NicolasJao/CAPSTONE-4TR1-Sushi-Assembly-Line/README.md

# CAPSTONE-4TR1-Sushi-Assembly-Line
My work for the PROCTECH 4TR1 course (McMaster BTech Automation). This is my CAPSTONE project with my group members. We are making an automated assembly line that makes sushi.
