NicolasJao/CAPSTONE-4TR1-Sushi-Assembly-Line/Project Documentation/Reports/Semester 1/Project Proposal Presentation.pdf

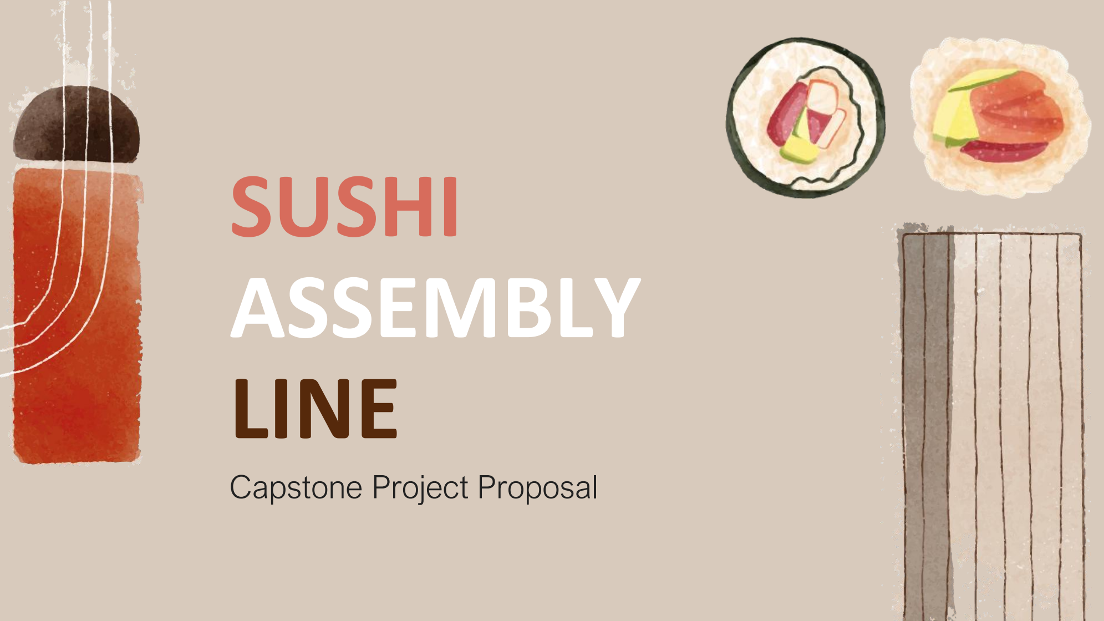
[picture p1: page 1]

# SUSHI ASSEMBLY LINE

# Capstone Project Proposal

# MEET THE TEAM

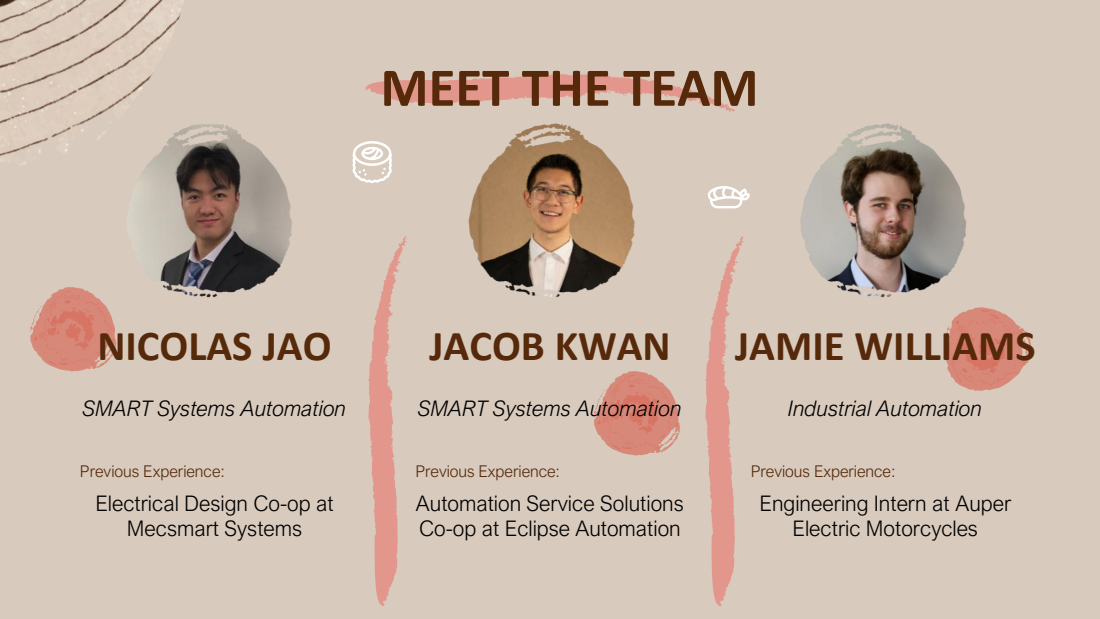
[picture p2: page 2]
NICOLAS JAO; JACOB KWAN; JAMIE WILLIAMS; SMART Systems Automation; Industrial Automation

Previous Experience:
Electrical Design Co-op at
Mecsmart Systems

Automation Service Solutions
Co-op at Eclipse Automation

Engineering Intern at Auper
Electric Motorcycles

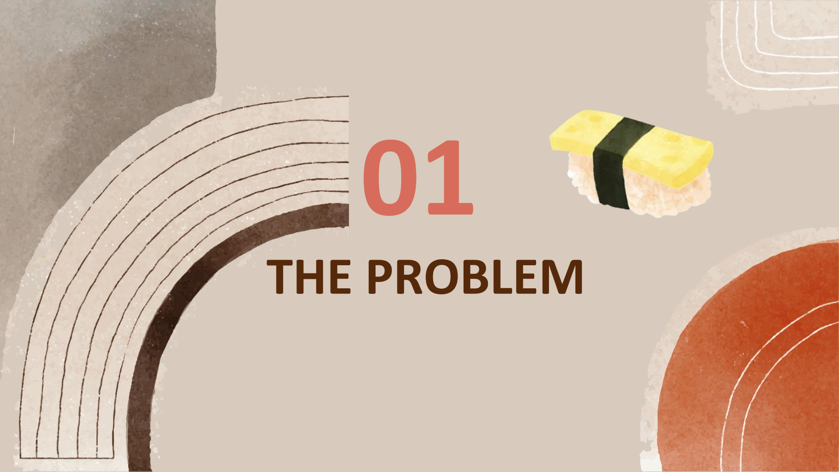
[picture p3: page 3]

# THE PROBLEM

01

# THE PROBLEM

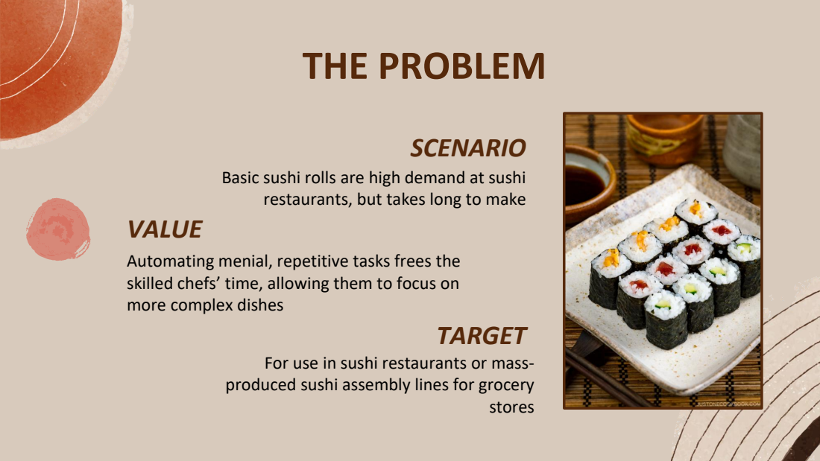
[picture p4: page 4]
SCENARIO; VALUE; TARGET; stores

Basic sushi rolls are high demand at sushi
restaurants, but takes long to make

Automating menial, repetitive tasks frees the
skilled chefs’ time, allowing them to focus on
more complex dishes

For use in sushi restaurants or mass-
produced sushi assembly lines for grocery

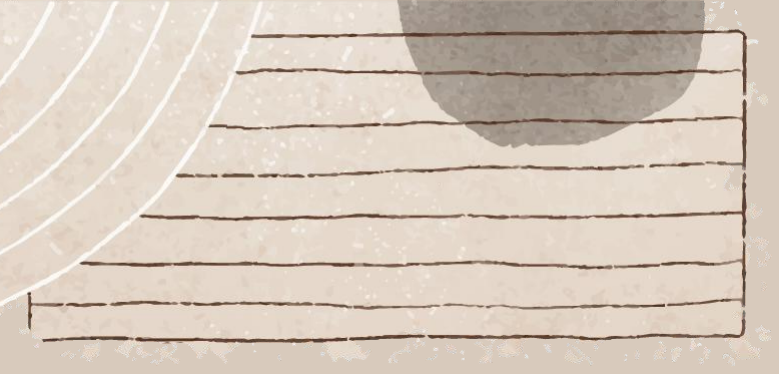
[picture p5: figure]

02

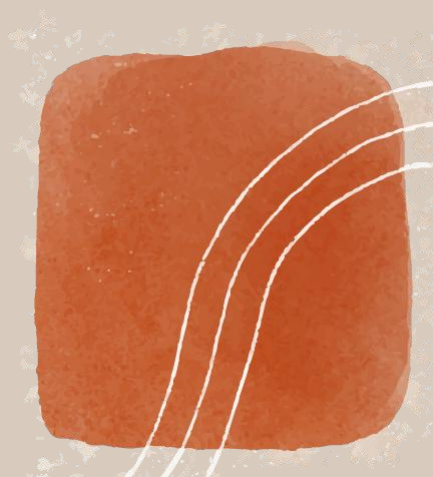
[picture p6: figure]

# THE MISSION

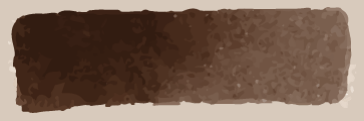
[picture p7: figure]
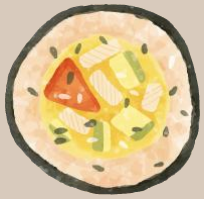
[picture p8: figure]

# THE MISSION

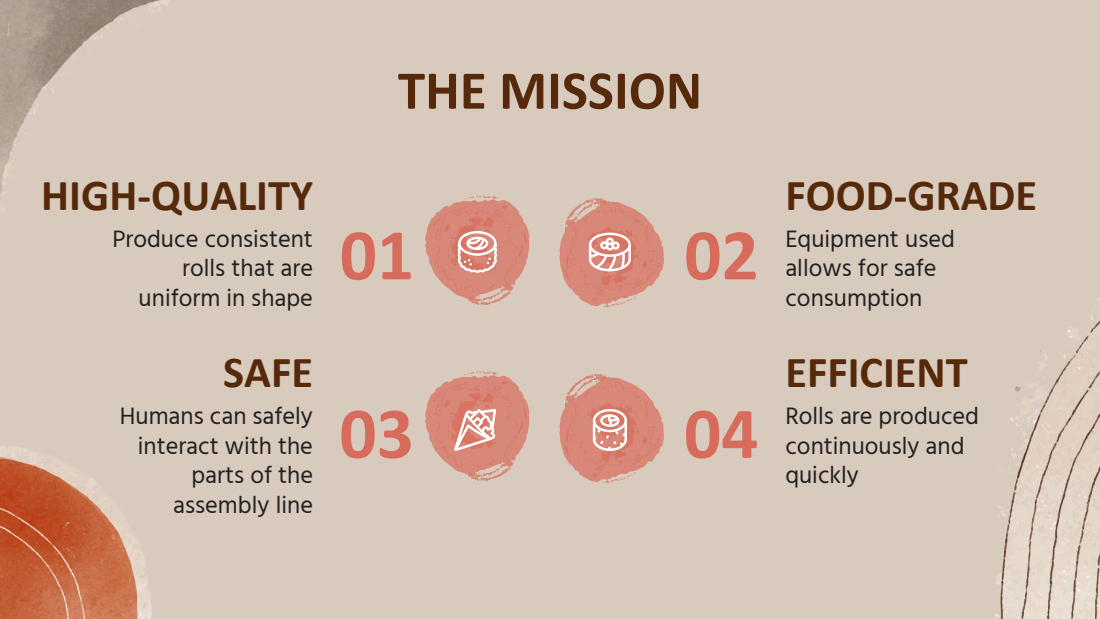
[picture p9: page 6]

HIGH-QUALITY
Produce consistent
rolls that are
uniform in shape
SAFE
Humans can safely

FOOD-GRADE
Equipment used
allows for safe
consumption
EFFICIENT
Rolls are produced
continuously and
quickly

interact with the
parts of the
assembly line

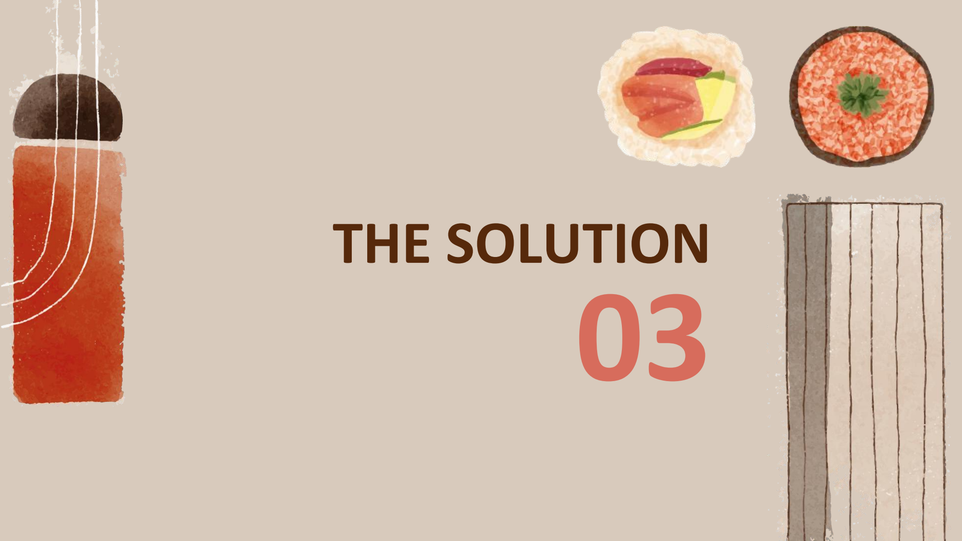
[picture p10: page 7]

# THE SOLUTION

03

## 01 Assembling the rice and nori

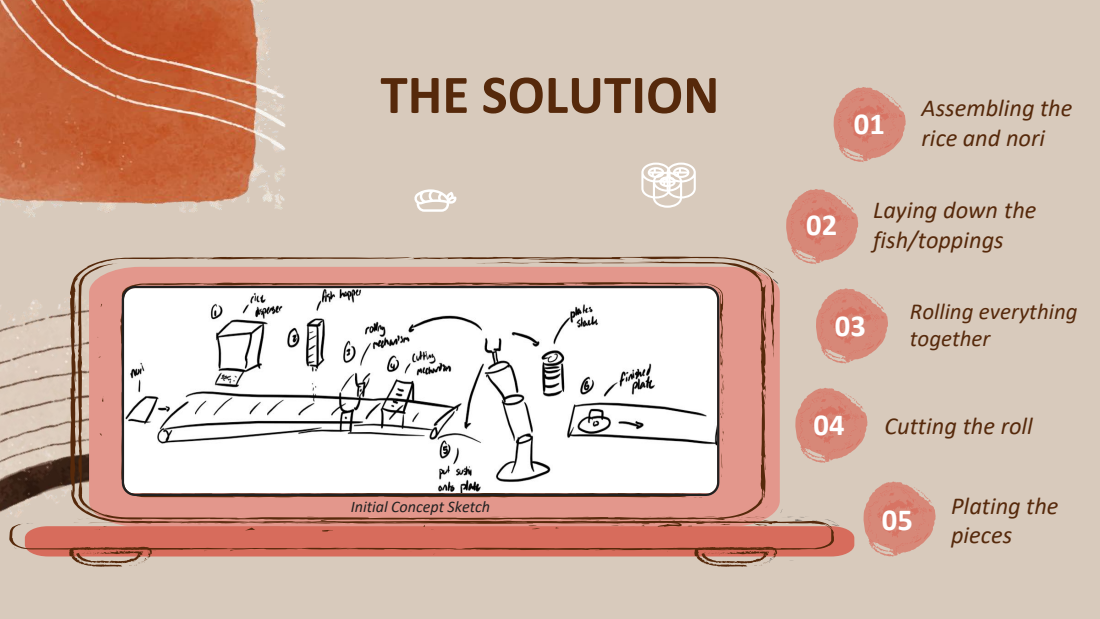
[picture p11: page 8]
03 Rolling everything together; 05 Plating the pieces; THE SOLUTION

02 Laying down the
fish/toppings

04 Cutting the roll

Initial Concept Sketch

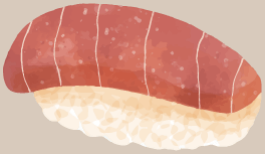
[picture p12: figure]

04

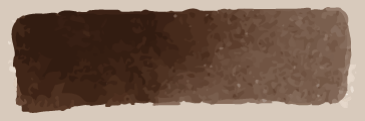
[picture p13: figure]
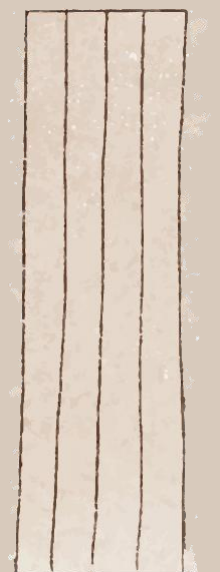
[picture p14: figure]

# THE TIMELINE

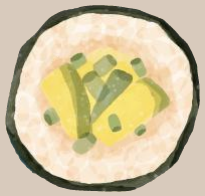
[picture p15: figure]
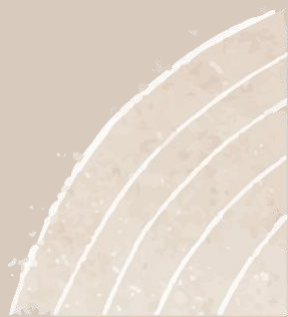
[picture p16: figure]

T
H

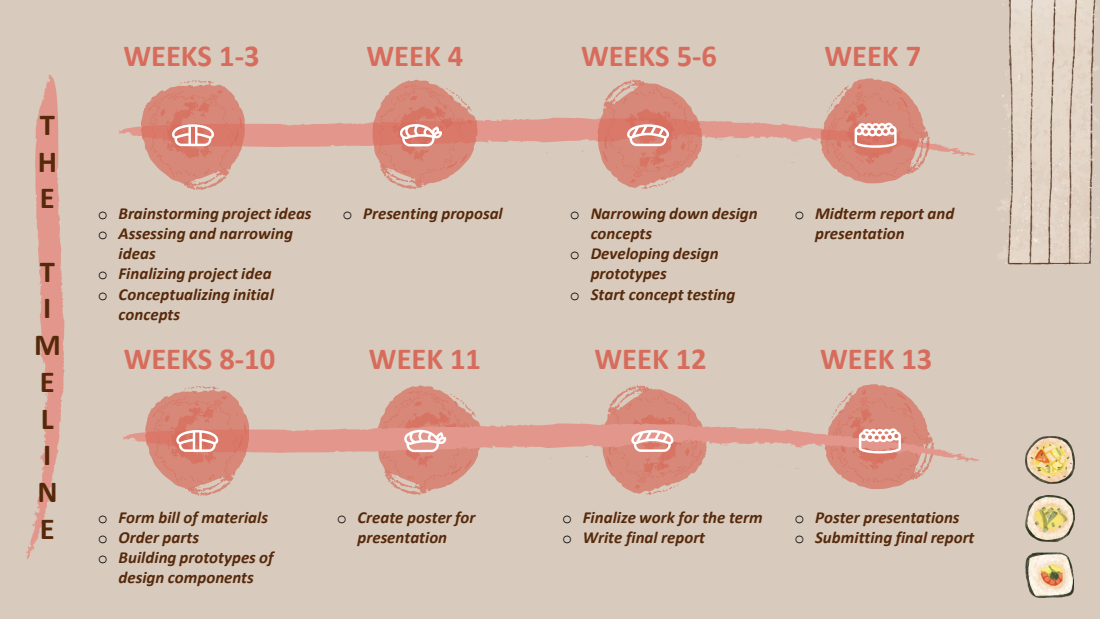
[picture p17: page 10]
• Brainstorming project ideas • Assessing and narrowing ideas; WEEKS 1-3; WEEK 4; WEEKS 5-6; WEEK 7; • Presenting proposal; o Narrowing down design; WEEKS 8-10; WEEK 11; WEEK 12; WEEK 13

• Midterm report and
presentation

concepts
• Developing design
prototypes
• Start concept testing

• Finalizing project idea
• Conceptualizing initial

• Form bill of materials
• Order parts
• Building prototypes of
design components

• Create poster for

• Finalize work for the term
• Write final report

• Poster presentations
• Submitting final report

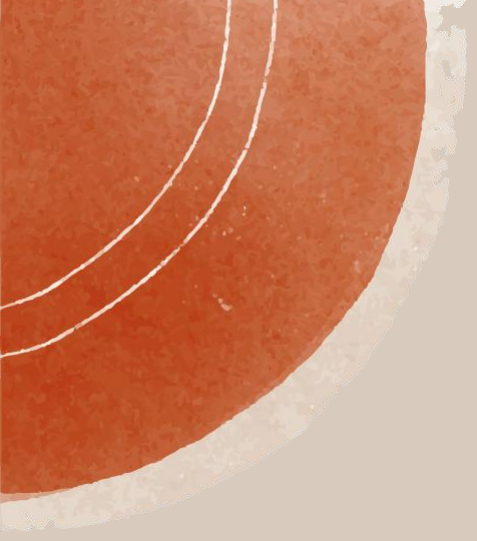
[picture p18: figure]
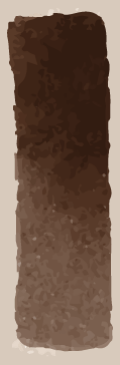
[picture p19: figure]

# THANK YOU

# QUESTIONS?

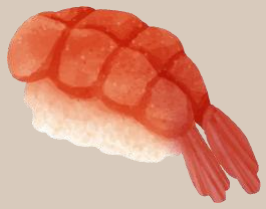
[picture p20: figure]
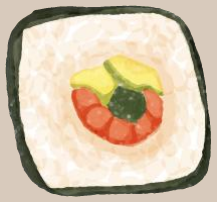
[picture p21: figure]
