NicolasJao/CAPSTONE-4TR1-Sushi-Assembly-Line/Project Documentation/Reports/Semester 2/Sushi Assembly Line Midterm Presentation 2.pdf

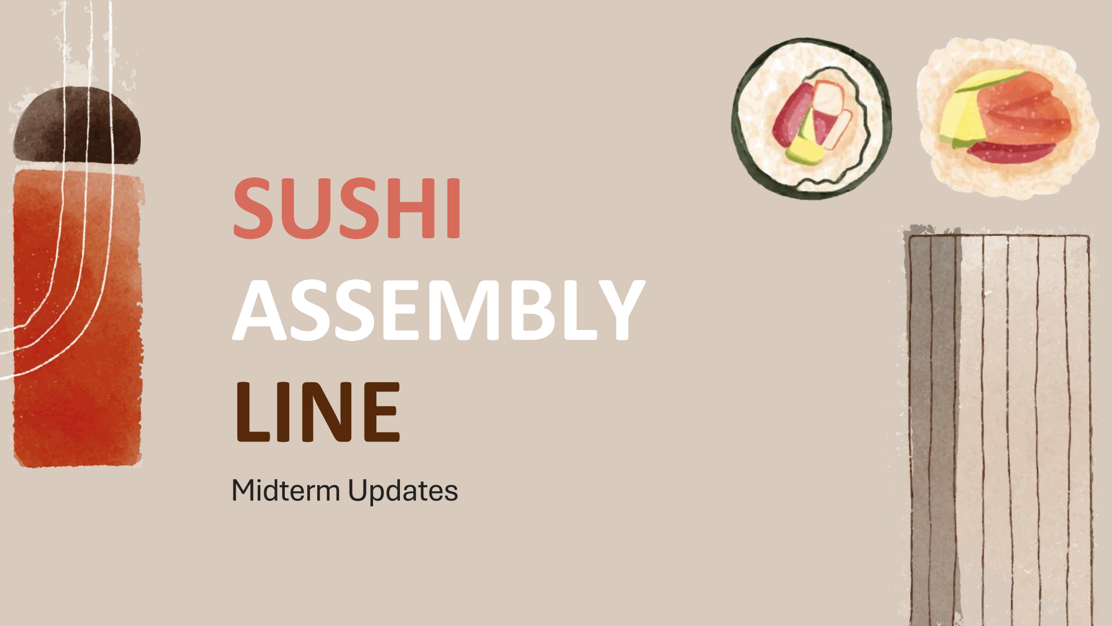
[picture p41: page 1]

# SUSHI ASSEMBLY LINE

## Midterm Updates

# MEET THE TEAM

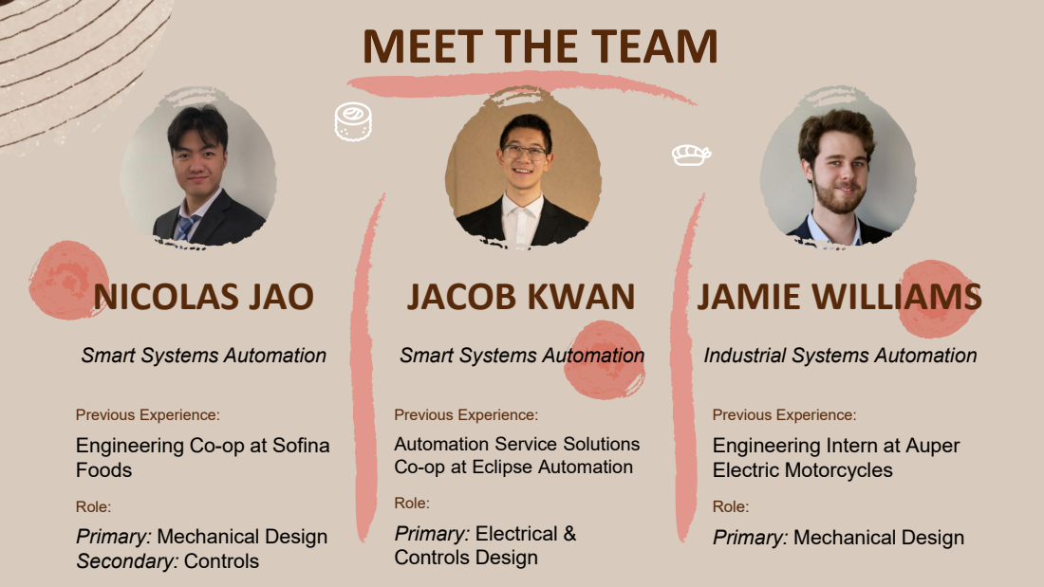
[picture p42: page 2]
NICOLAS JAO; JACOB KWAN; JAMIE WILLIAMS; Smart Systems Automation; Industrial Systems Automation; Role: Primary: Electrical & Controls Design

Previous Experience:
Engineering Co-op at Sofina
Foods

Automation Service Solutions
Co-op at Eclipse Automation

Engineering Intern at Auper
Electric Motorcycles

Role:
Primary: Mechanical Design
Secondary: Controls

01

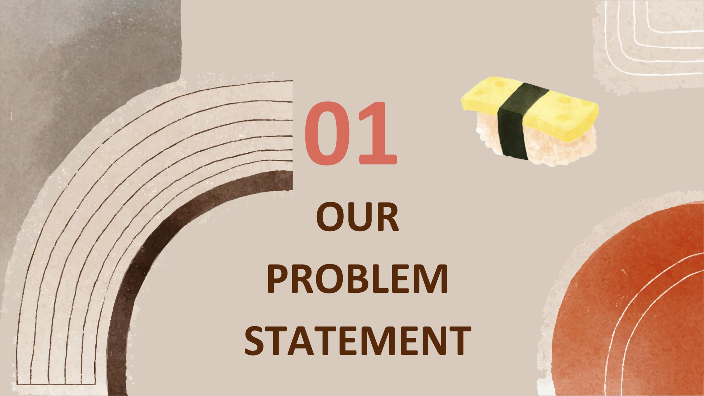
[picture p43: page 3]

# OUR PROBLEM STATEMENT

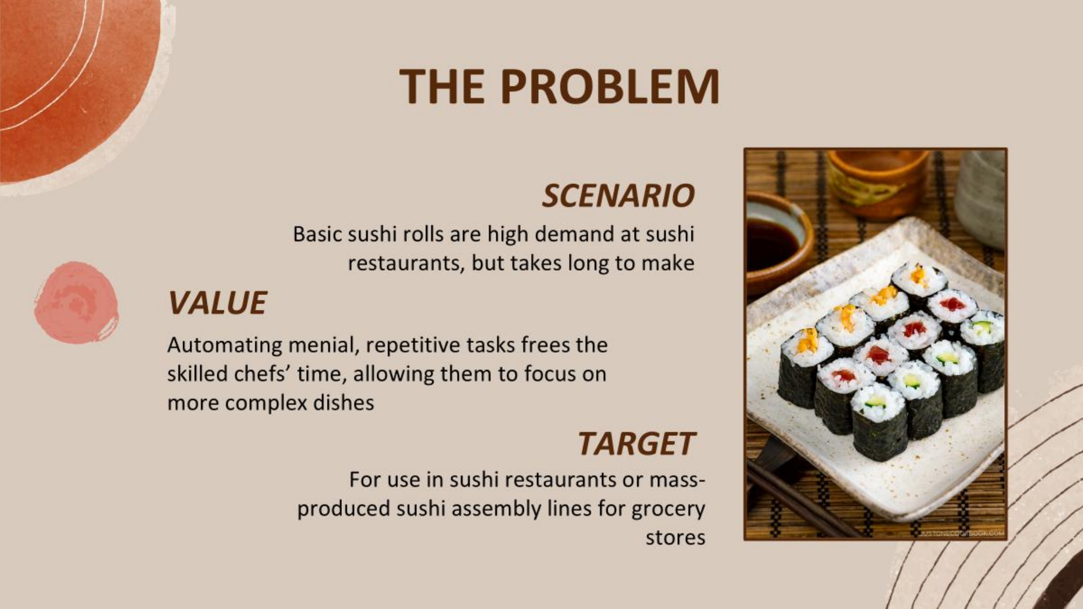
[picture p44: page 4]

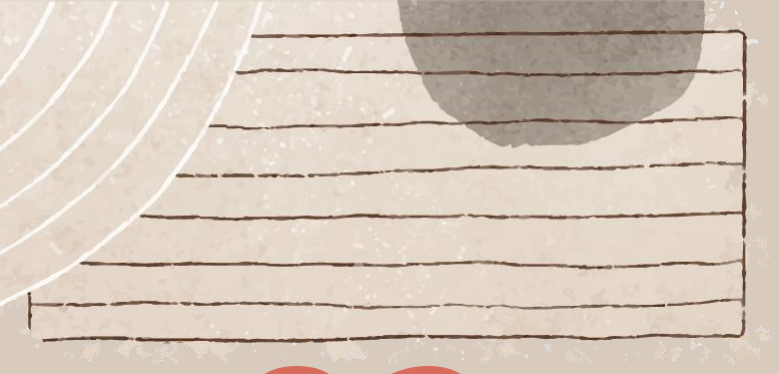
[picture p45: figure]

02


# OUR OBJECTIVES AND DESIGNS


# OBJECTIVES

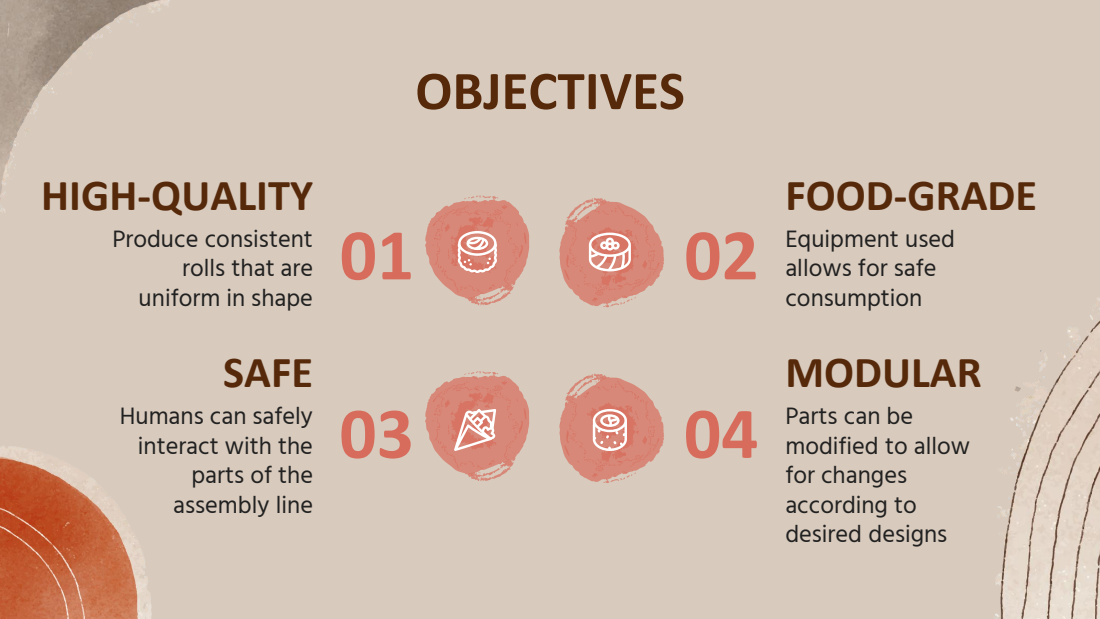
[picture p46: page 6]

HIGH-QUALITY
Produce consistent
rolls that are
uniform in shape
SAFE
Humans can safely

FOOD-GRADE
Equipment used
allows for safe
consumption
MODULAR
Parts can be
modified to allow
for changes
according to
desired designs

interact with the
parts of the
assembly line

# 5 STATIONS:

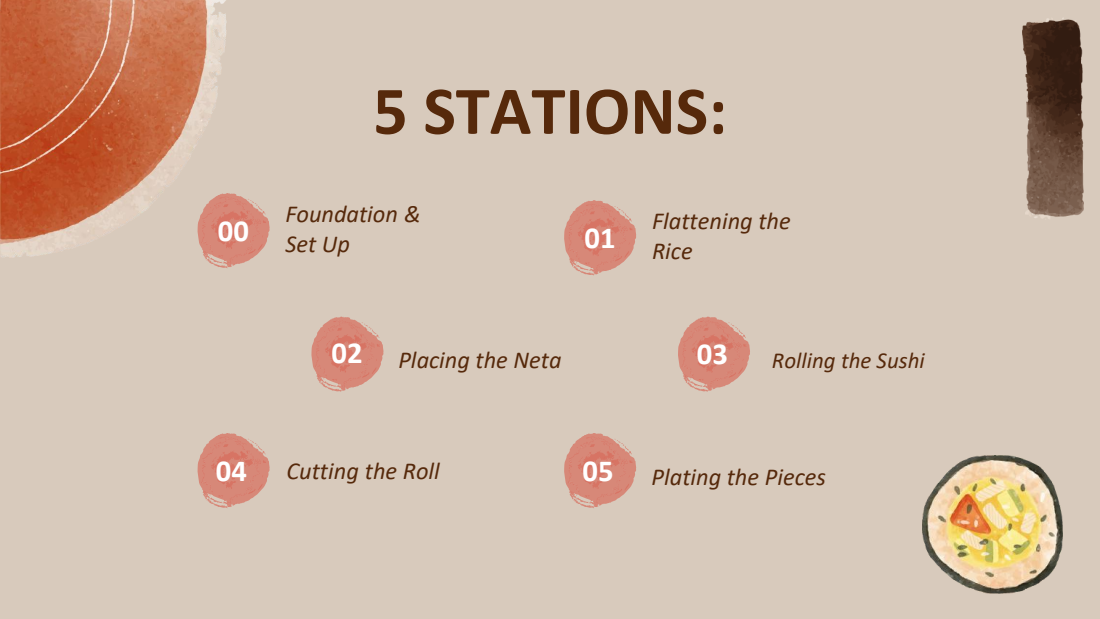
[picture p47: page 7]
00 Foundation & Set Up; Cutting the Roll; Plating the Pieces; 02 Placing the Neta; Rolling the Sushi; 01 Flattening the Rice

# 0. FOUNDATION & SET UP

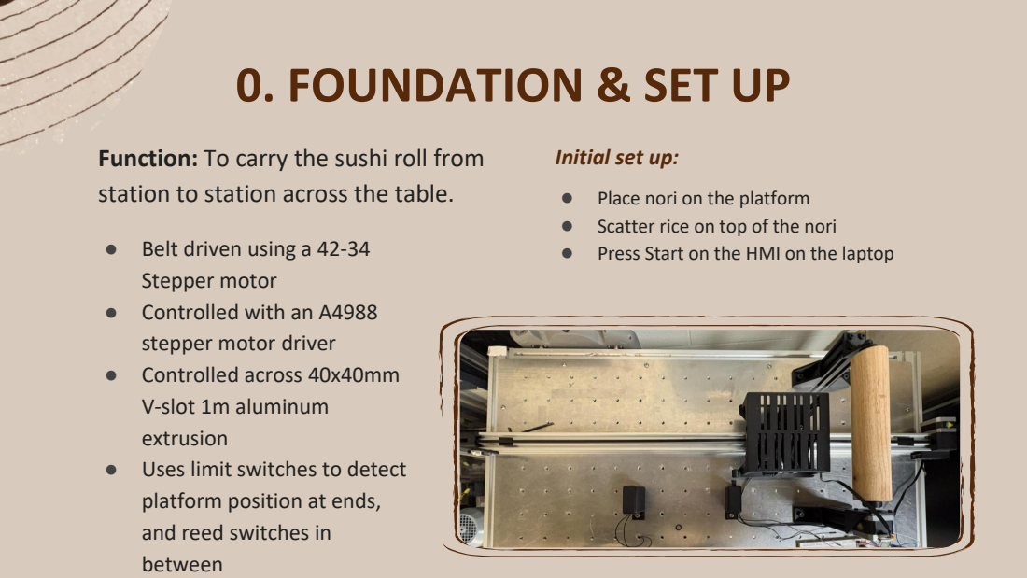
[picture p48: page 8]

Function: To carry the sushi roll from
station to station across the table.

Initial set up:

● Place nori on the platform
● Scatter rice on top of the nori
● Press Start on the HMI on the laptop

● Belt driven using a 42-34
Stepper motor
● Controlled with an A4988
stepper motor driver
● Controlled across 40x40mm
V-slot 1m aluminum
extrusion
● Uses limit switches to detect
platform position at ends,
and reed switches in
between

# 1. FLATTENING THE RICE

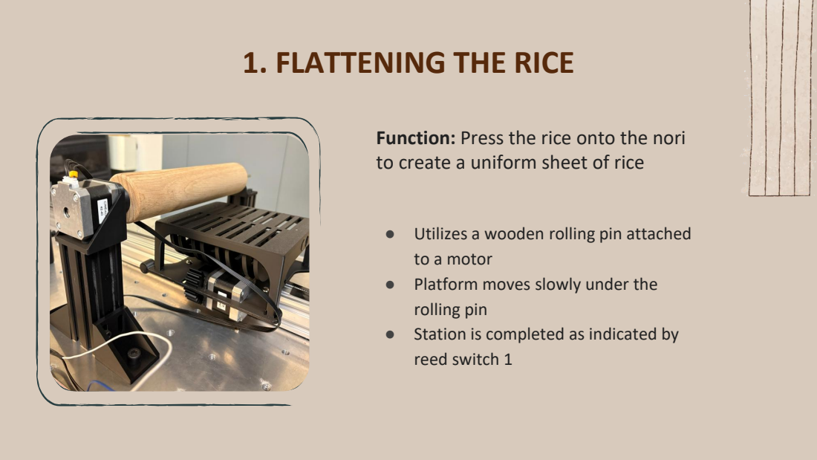
[picture p49: page 9]

Function: Press the rice onto the nori
to create a uniform sheet of rice

● Utilizes a wooden rolling pin attached
to a motor
● Platform moves slowly under the
rolling pin
● Station is completed as indicated by
reed switch 1

# 2. PLACING THE NETA (TOPPINGS)

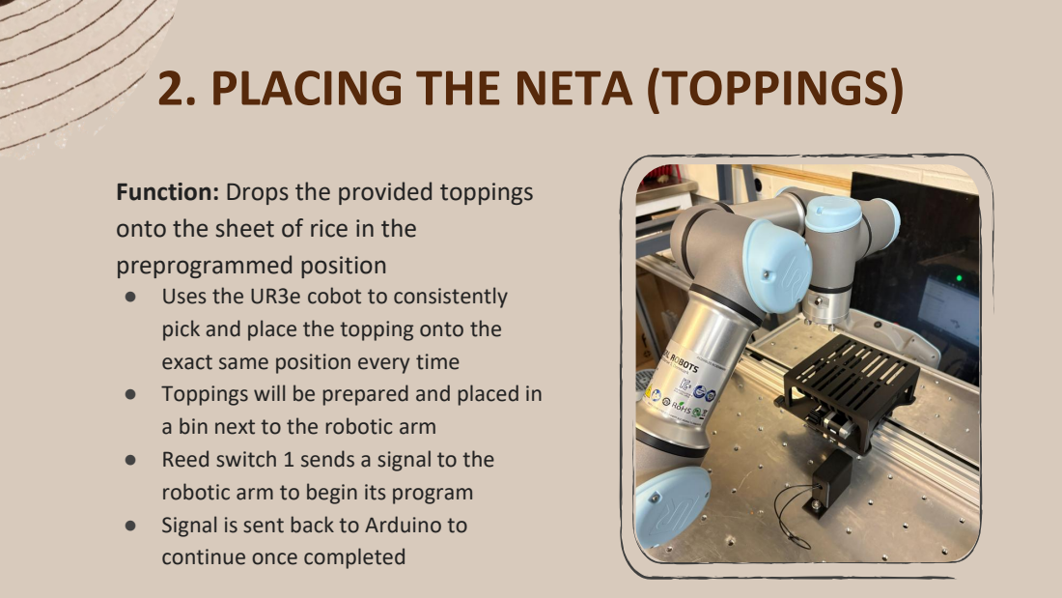
[picture p50: page 10]

Function: Drops the provided toppings
onto the sheet of rice in the
preprogrammed position
● Uses the UR3e cobot to consistently
pick and place the topping onto the
exact same position every time
● Toppings will be prepared and placed in
a bin next to the robotic arm
● Reed switch 1 sends a signal to the
robotic arm to begin its program
● Signal is sent back to Arduino to
continue once completed

# 3. ROLLING THE SUSHI

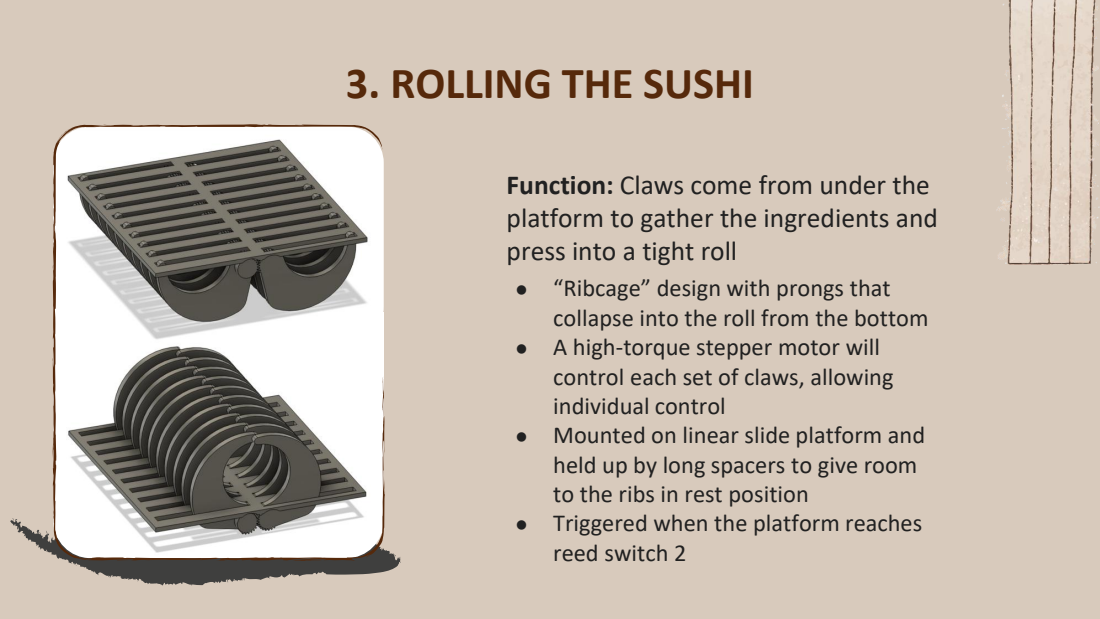
[picture p51: page 11]

Function: Claws come from under the
platform to gather the ingredients and
press into a tight roll
● “Ribcage” design with prongs that
collapse into the roll from the bottom
● A high-torque stepper motor will
control each set of claws, allowing
individual control
● Mounted on linear slide platform and
held up by long spacers to give room
to the ribs in rest position
● Triggered when the platform reaches
reed switch 2

# 4. CUTTING THE ROLL

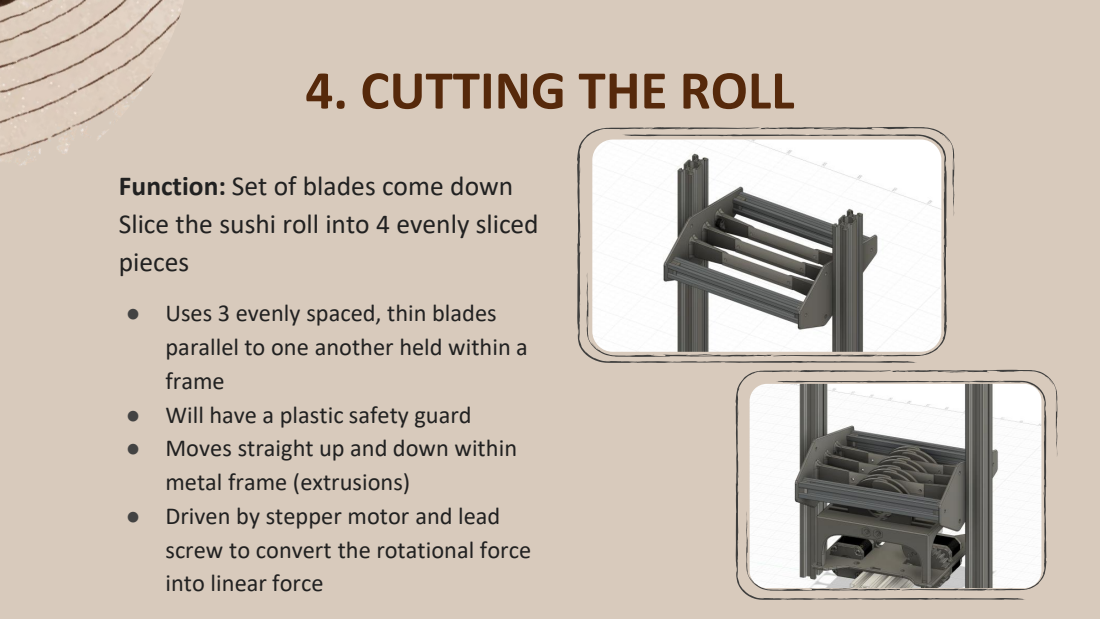
[picture p52: page 12]

Function: Set of blades come down
Slice the sushi roll into 4 evenly sliced
pieces

● Uses 3 evenly spaced, thin blades
parallel to one another held within a
frame
● Will have a plastic safety guard
● Moves straight up and down within
metal frame (extrusions)
● Driven by stepper motor and lead
screw to convert the rotational force
into linear force

# 5. PLATING THE ROLLS

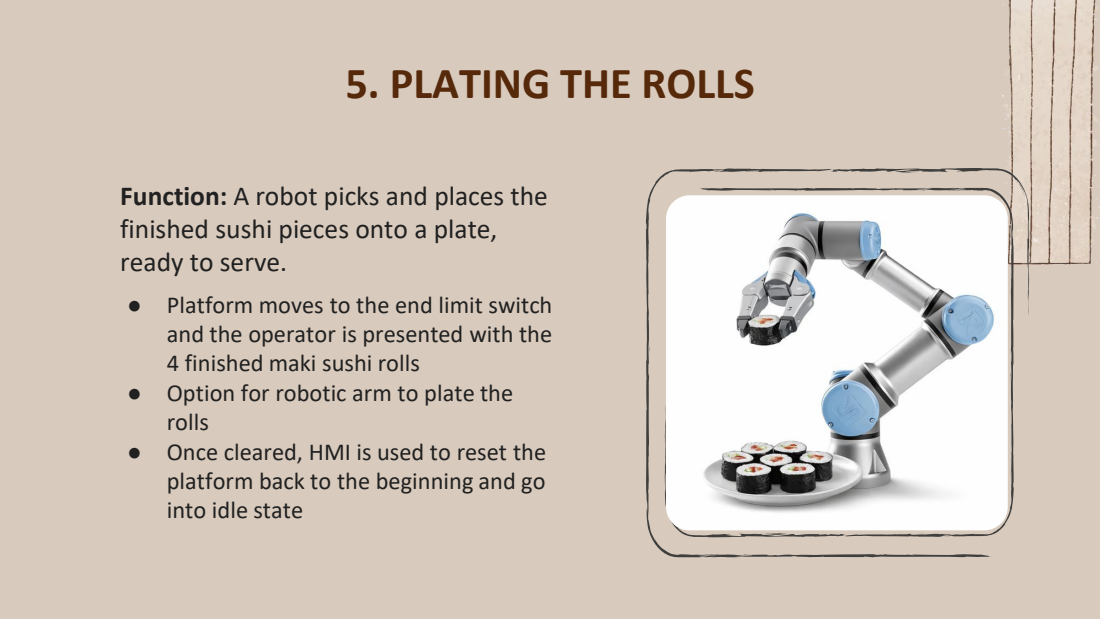
[picture p53: page 13]

Function: A robot picks and places the
finished sushi pieces onto a plate,
ready to serve.
● Platform moves to the end limit switch
and the operator is presented with the
4 finished maki sushi rolls
● Option for robotic arm to plate the
rolls
● Once cleared, HMI is used to reset the
platform back to the beginning and go
into idle state


03

# WHAT WE’VE ACHIEVED

T
H

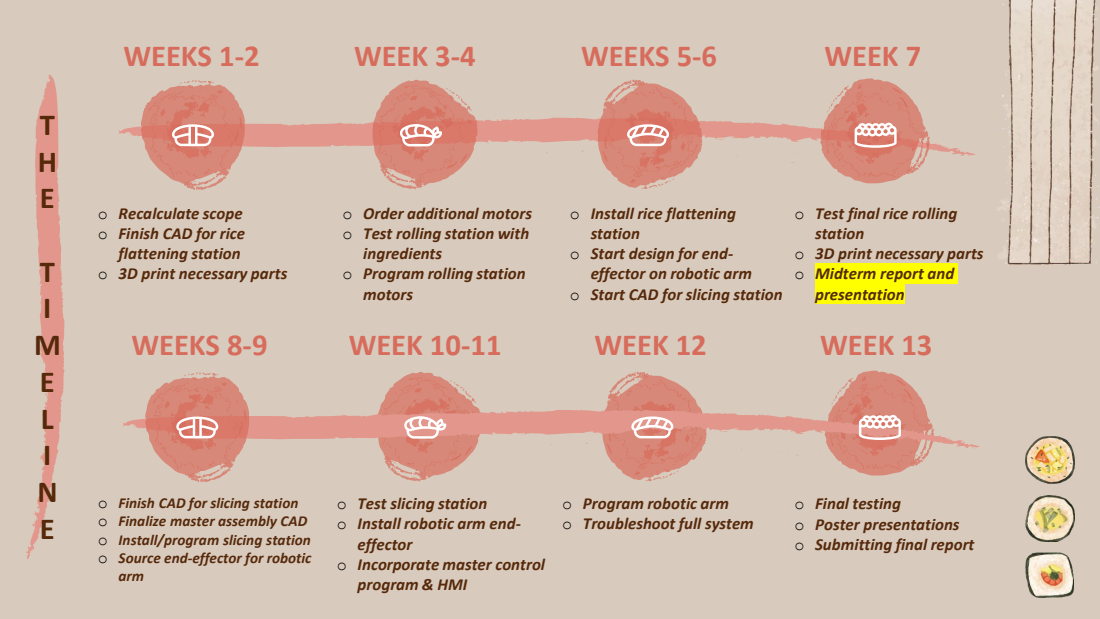
[picture p54: page 15]
• Recalculate scope • Finish CAD for rice flattening station; WEEKS 1-2; WEEK 3-4; WEEKS 5-6; WEEK 7; WEEKS 8-9; WEEK 10-11; WEEK 12; WEEK 13

• Order additional motors
• Test rolling station with
ingredients
• Program rolling station
motors

• Install rice flattening
station
• Start design for end-
effector on robotic arm
• Start CAD for slicing station

• Test final rice rolling
• 3D print necessary parts
• Midterm report and
presentation

• Finish CAD for slicing station
• Finalize master assembly CAD
• Install/program slicing station
• Source end-effector for robotic
arm

• Test slicing station
• Install robotic arm end-
effector
• Incorporate master control
program & HMI

• Program robotic arm
• Troubleshoot full system

• Final testing
• Poster presentations
• Submitting final report

# PROGRESS ON CAD DESIGN

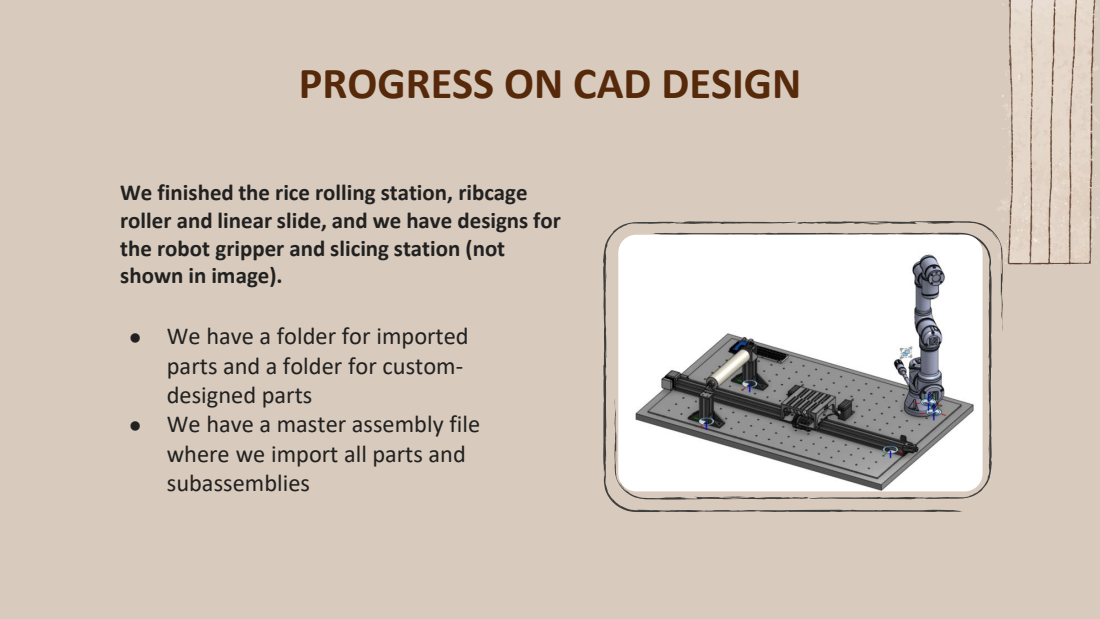
[picture p55: page 16]

We finished the rice rolling station, ribcage
roller and linear slide, and we have designs for
the robot gripper and slicing station (not
shown in image).

● We have a folder for imported
parts and a folder for custom-
designed parts
● We have a master assembly file
where we import all parts and
subassemblies

# PROGRESS ON CAD DESIGN

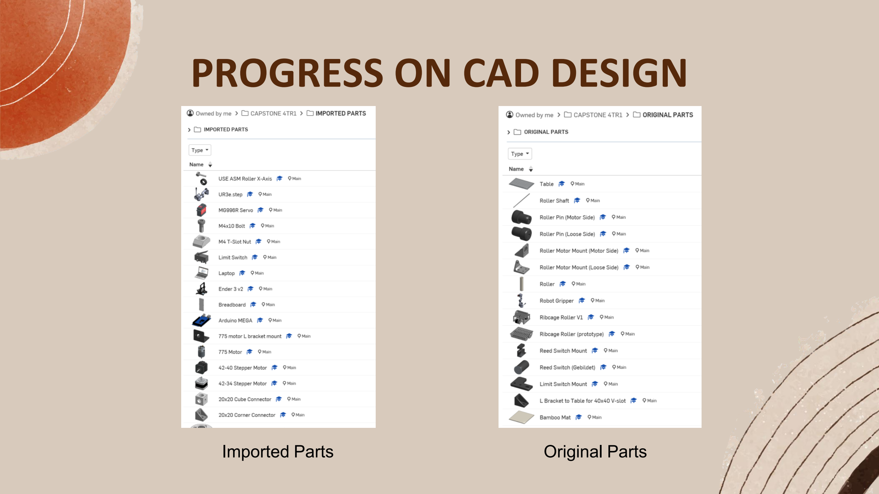
[picture p56: page 17]

Imported Parts | Original Parts

# PROGRESS ON CAD DESIGN

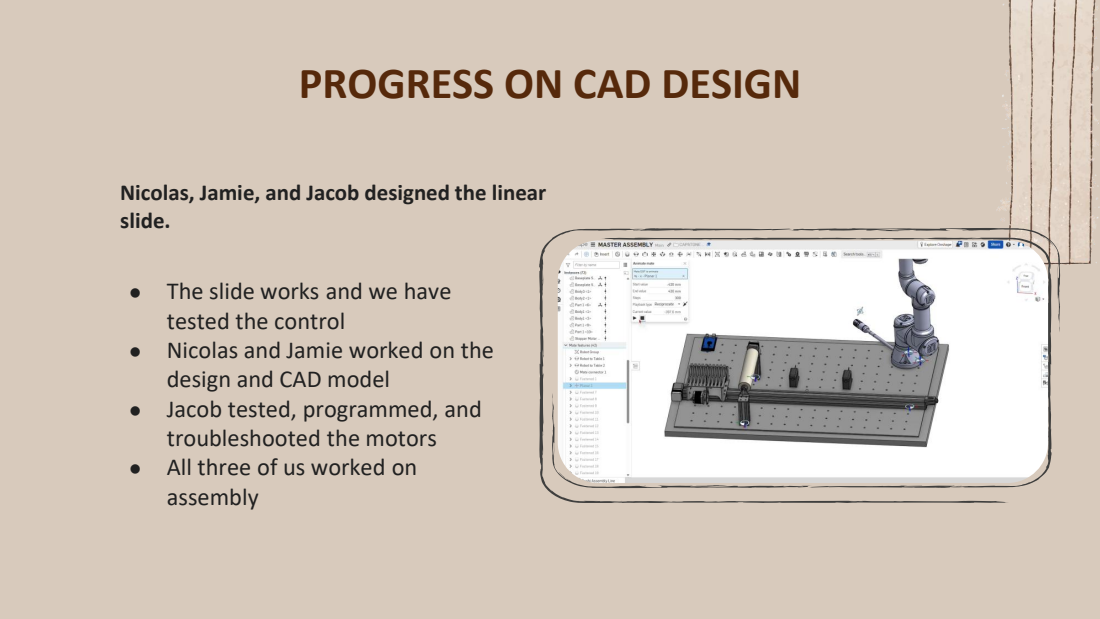
[picture p57: page 18]

Nicolas, Jamie, and Jacob designed the linear
slide.

● The slide works and we have
tested the control
● Nicolas and Jamie worked on the
design and CAD model
● Jacob tested, programmed, and
troubleshooted the motors
● All three of us worked on
assembly

# PROGRESS ON CAD DESIGN

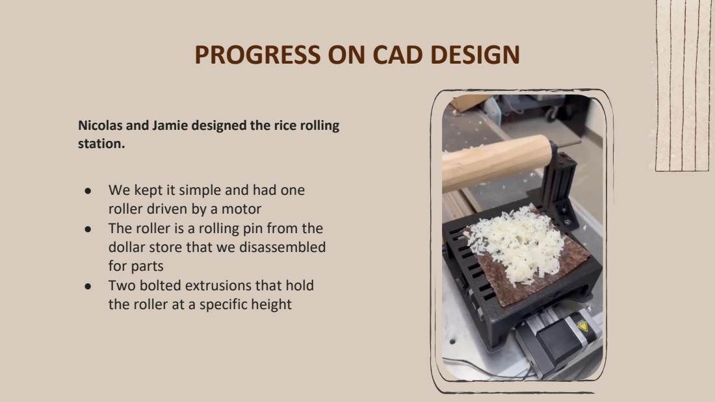
[picture p58: page 19]

Nicolas and Jamie designed the rice rolling
station.

● We kept it simple and had one
roller driven by a motor
● The roller is a rolling pin from the
dollar store that we disassembled
for parts
● Two bolted extrusions that hold
the roller at a specific height

# Roller Station Assembly

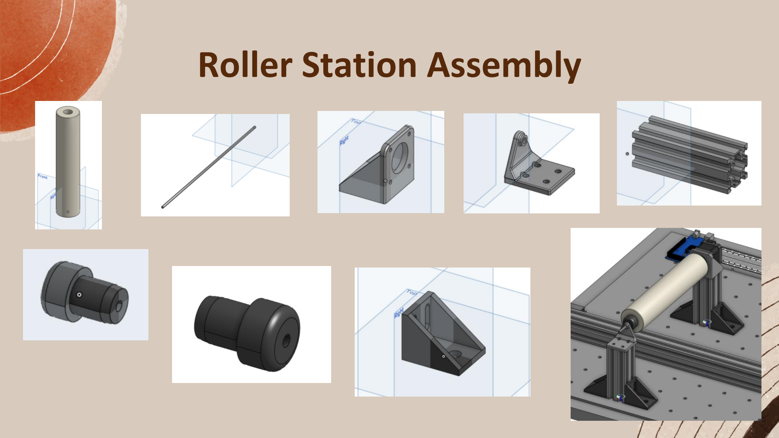
[picture p59: page 20]

# PROGRESS ON CAD DESIGN

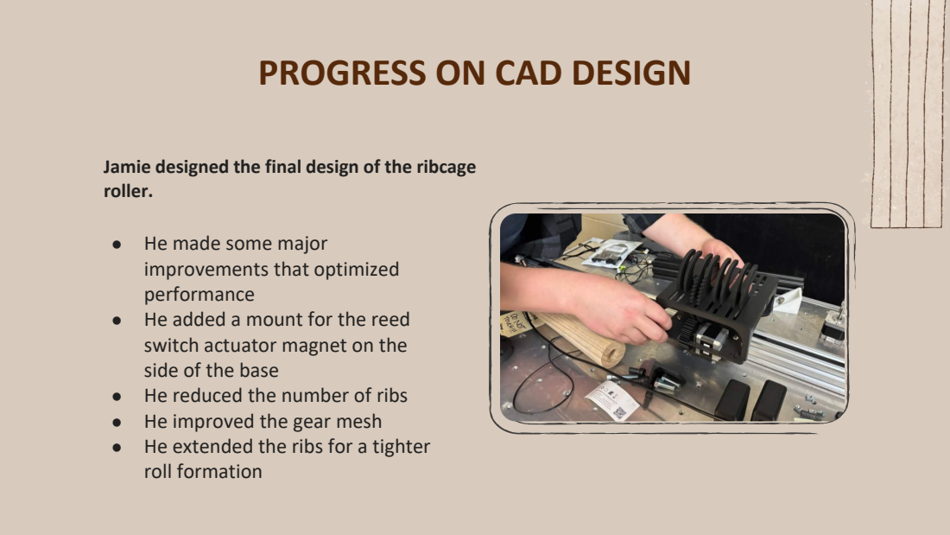
[picture p60: page 21]

Jamie designed the final design of the ribcage
roller.

● He made some major
improvements that optimized
performance
● He added a mount for the reed
switch actuator magnet on the
side of the base
● He reduced the number of ribs
● He improved the gear mesh
● He extended the ribs for a tighter
roll formation

# Ribcage Roller Assembly (V1)

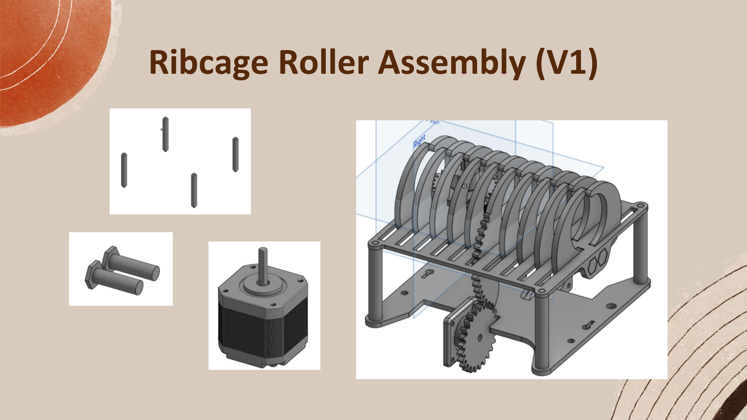
[picture p61: page 22]

# Ribcage Roller Assembly (V2)

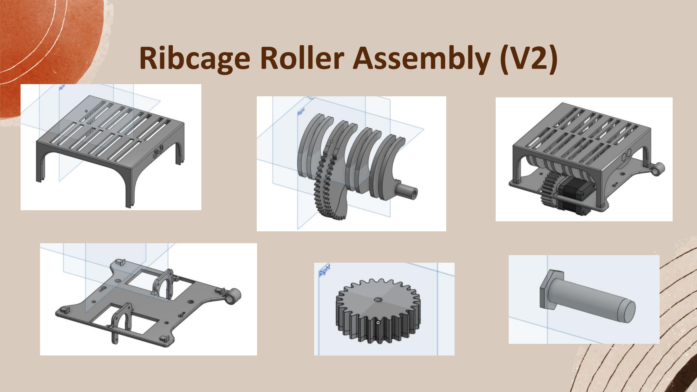
[picture p62: page 23]

# PROGRESS ON CAD DESIGN

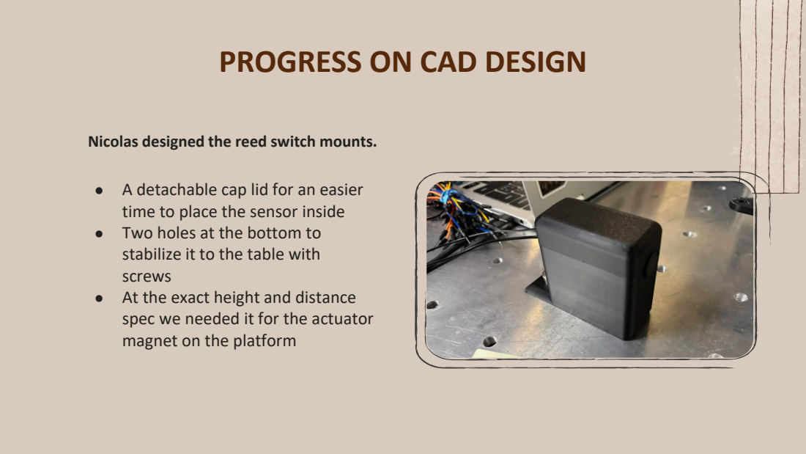
[picture p63: page 24]

Nicolas designed the reed switch mounts.

● A detachable cap lid for an easier
time to place the sensor inside
● Two holes at the bottom to
stabilize it to the table with
screws
● At the exact height and distance
spec we needed it for the actuator
magnet on the platform

# Reed Switch Mount Assembly

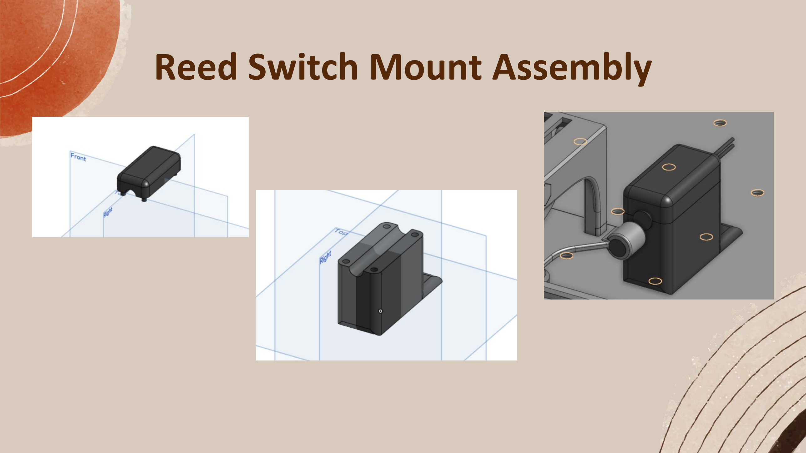
[picture p64: page 25]

# PROGRESS ON CAD DESIGN

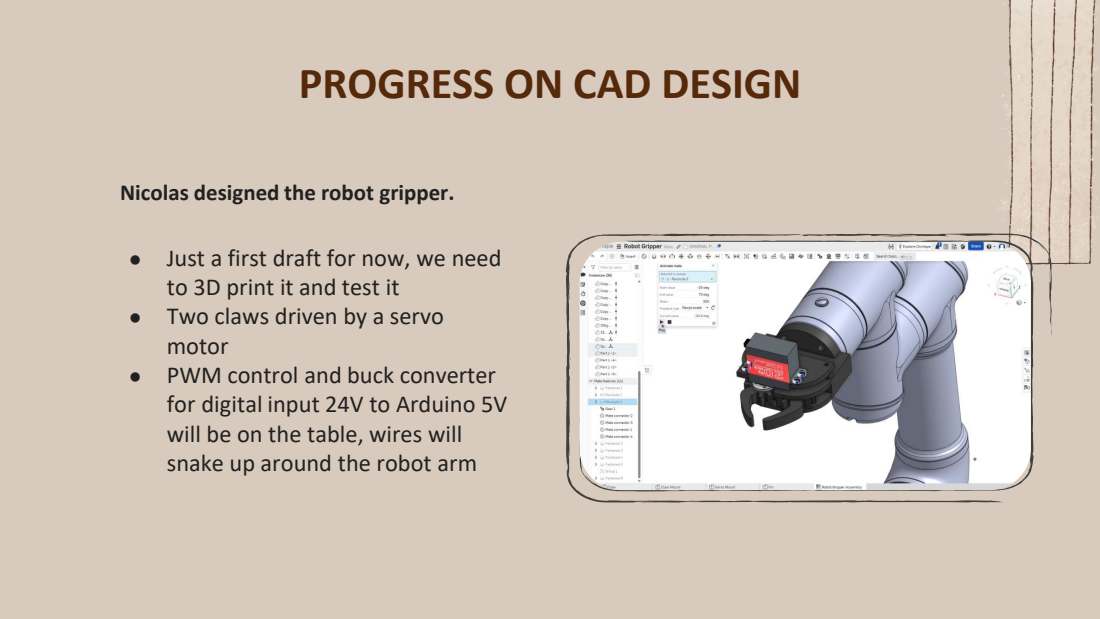
[picture p65: page 26]

Nicolas designed the robot gripper.

● Just a first draft for now, we need
to 3D print it and test it
● Two claws driven by a servo
motor
● PWM control and buck converter
for digital input 24V to Arduino 5V
will be on the table, wires will
snake up around the robot arm

# Robot Gripper Assembly

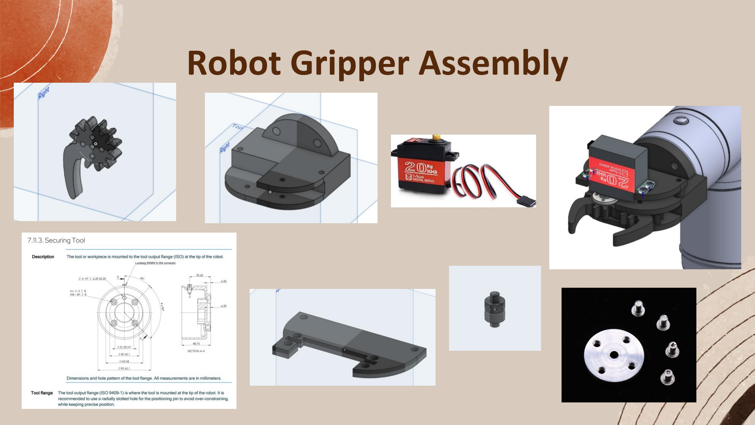
[picture p66: page 27]

# Robot Gripper Control

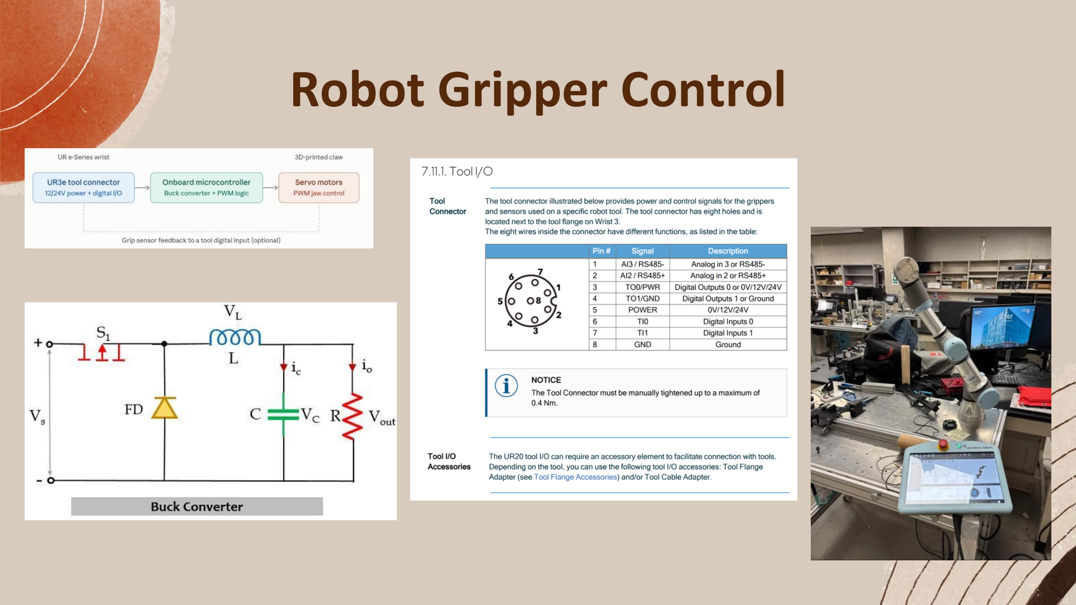
[picture p67: page 28]

# PROGRESS ON CAD DESIGN

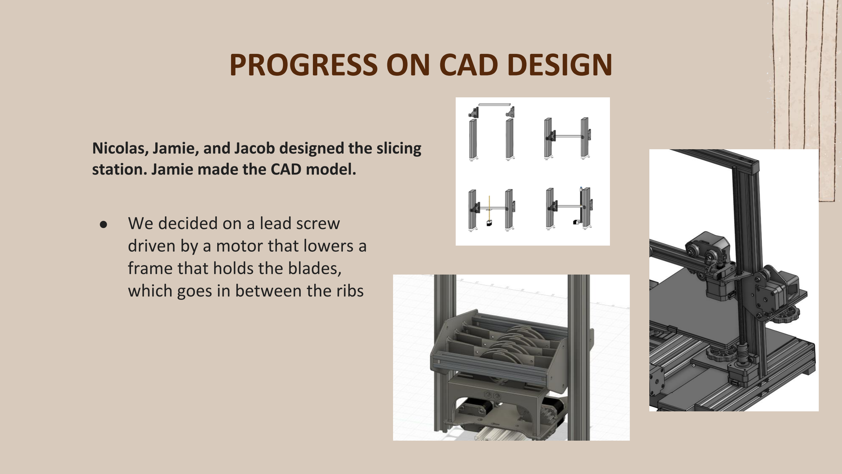
[picture p68: page 29]

- We decided on a lead screw driven by a motor that lowers a frame that holds the blades, which goes in between the ribs

Nicolas, Jamie, and Jacob designed the slicing station. Jamie made the CAD model.

# PROGRESS ON CONTROL

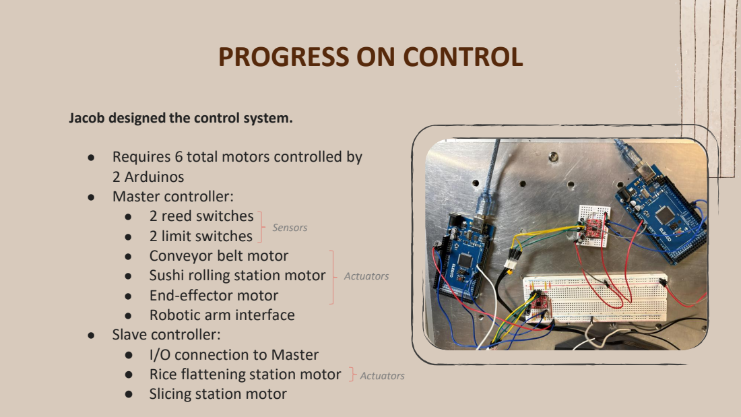
[picture p69: page 30]
Sensors; Actuators

Jacob designed the control system.

● Requires 6 total motors controlled by
2 Arduinos
● Master controller:
● 2 reed switches
● 2 limit switches
● Conveyor belt motor
● Sushi rolling station motor
● End-effector motor
● Robotic arm interface
● Slave controller:
● I/O connection to Master
● Rice flattening station motor
● Slicing station motor

# ARDUINO TEST CODE

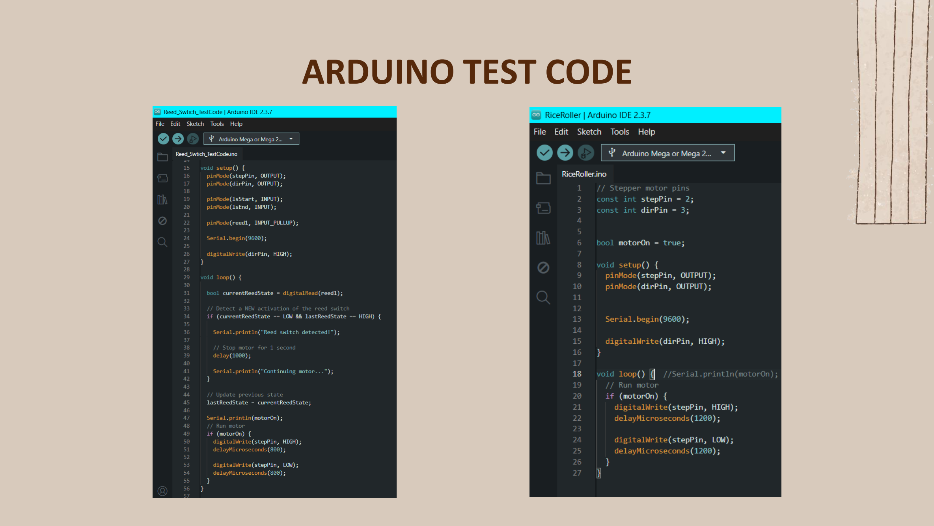
[picture p70: page 31]

# NEXT STEPS

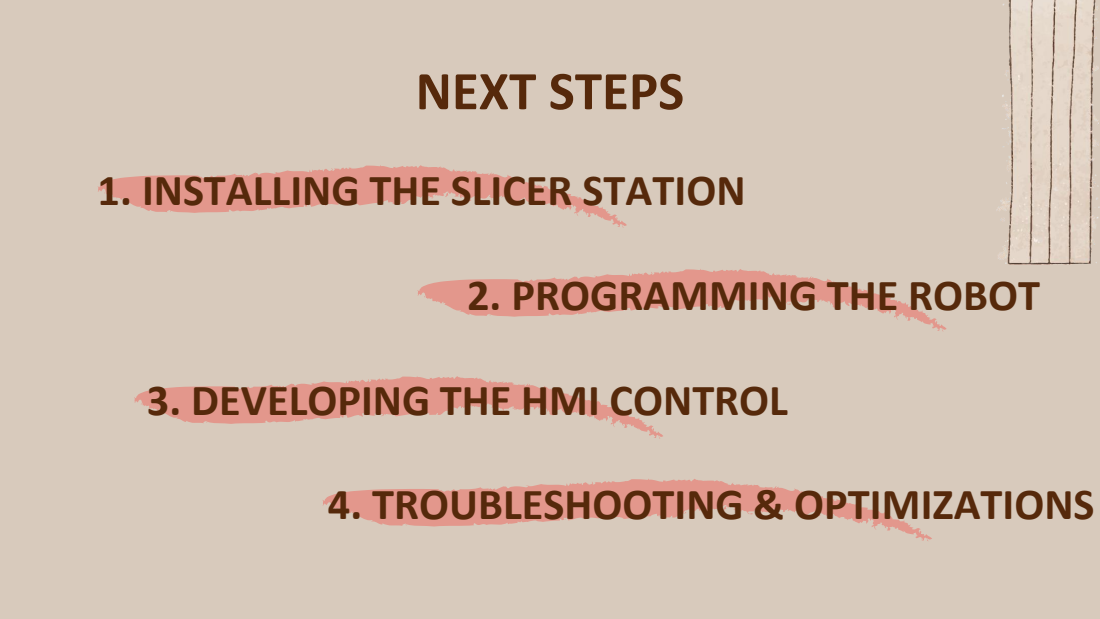
[picture p71: page 32]
4. TROUBLESHOOTING & OPTIMIZATIONS

1. INSTALLING THE SLICER STATION

2. PROGRAMMING THE ROBOT

3. DEVELOPING THE HMI CONTROL

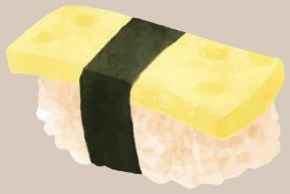
[picture p72: figure]

# Thanks for listening

## First investors get a pack of sushi for free!
