NicolasJao/CAPSTONE-4TR1-Sushi-Assembly-Line/Project Documentation/Reports/Semester 1/Sushi Assembly Line Midterm Presentation.pdf

# SUSHI

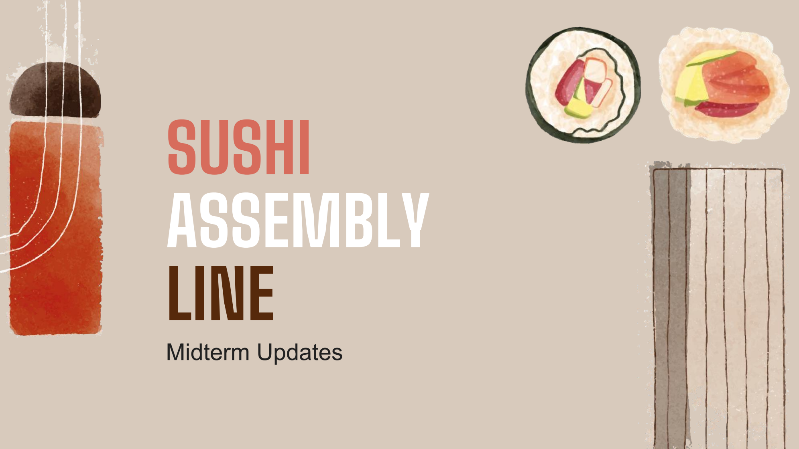
[picture p83: page 1]

# ASSEMBLY LINE

Midterm Updates

# MEET THE TEAM

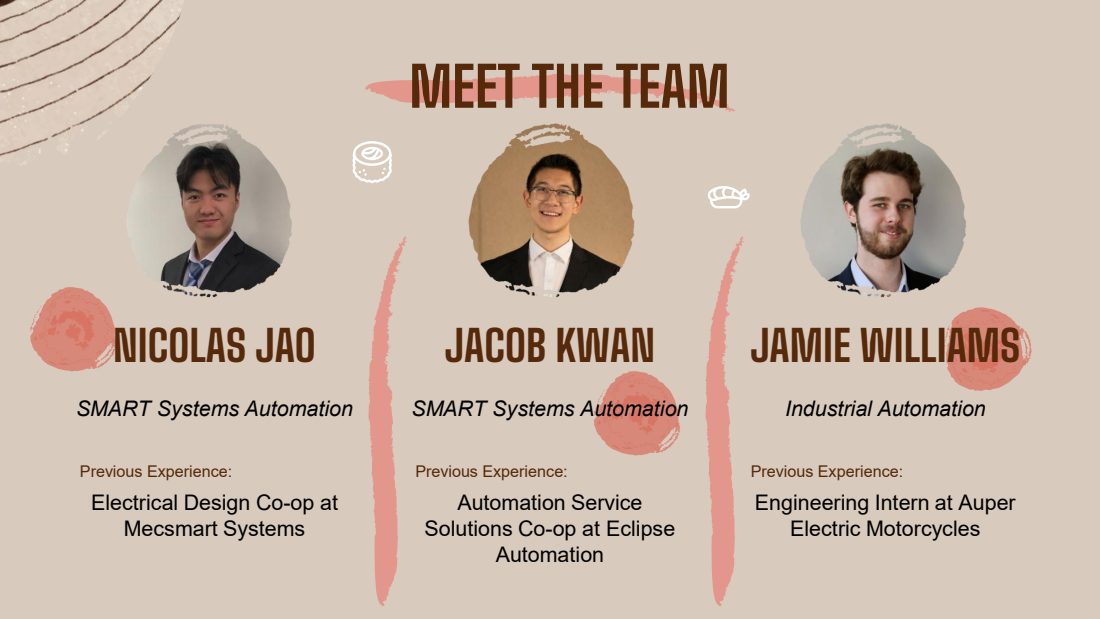
[picture p84: page 2]
NICOLAS JAO; JACOB KWAN; JAMIE WILLIAMS; SMART Systems Automation; Industrial Automation; Automation

Previous Experience:
Electrical Design Co-op at
Mecsmart Systems

Automation Service
Solutions Co-op at Eclipse

Engineering Intern at Auper
Electric Motorcycles

01

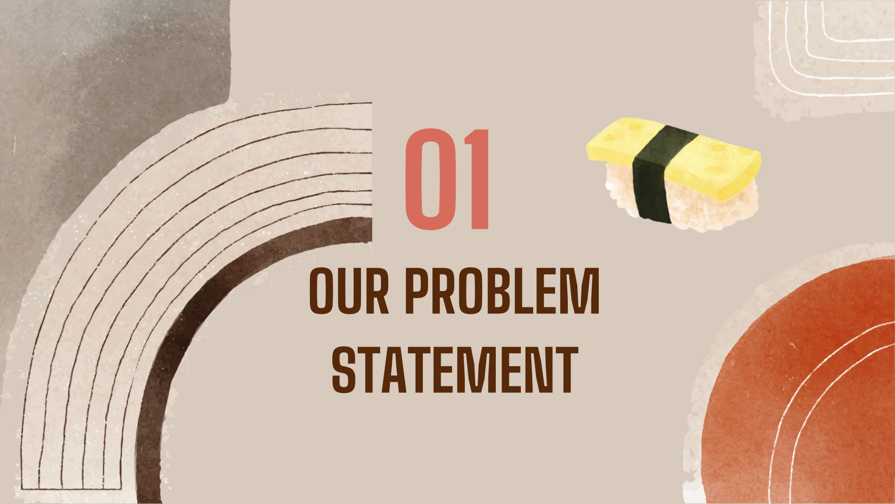
[picture p85: page 3]

# OUR PROBLEM STATEMENT

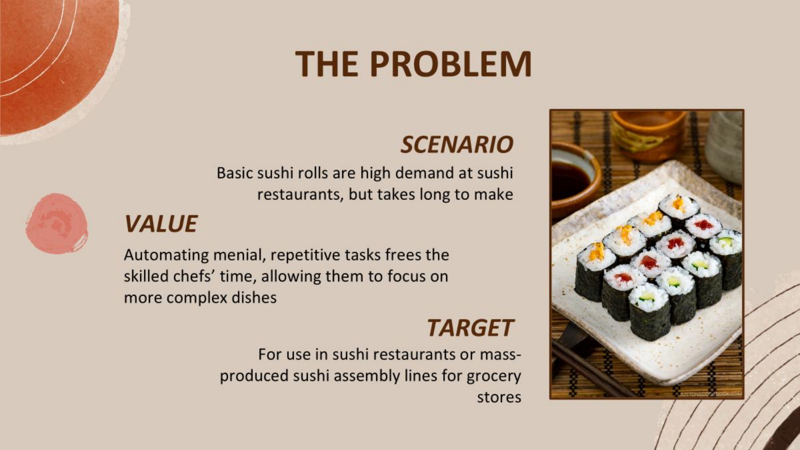
[picture p86: page 4]


02


# OUR OBJECTIVES AND DESIGNS


# OBJECTIVES

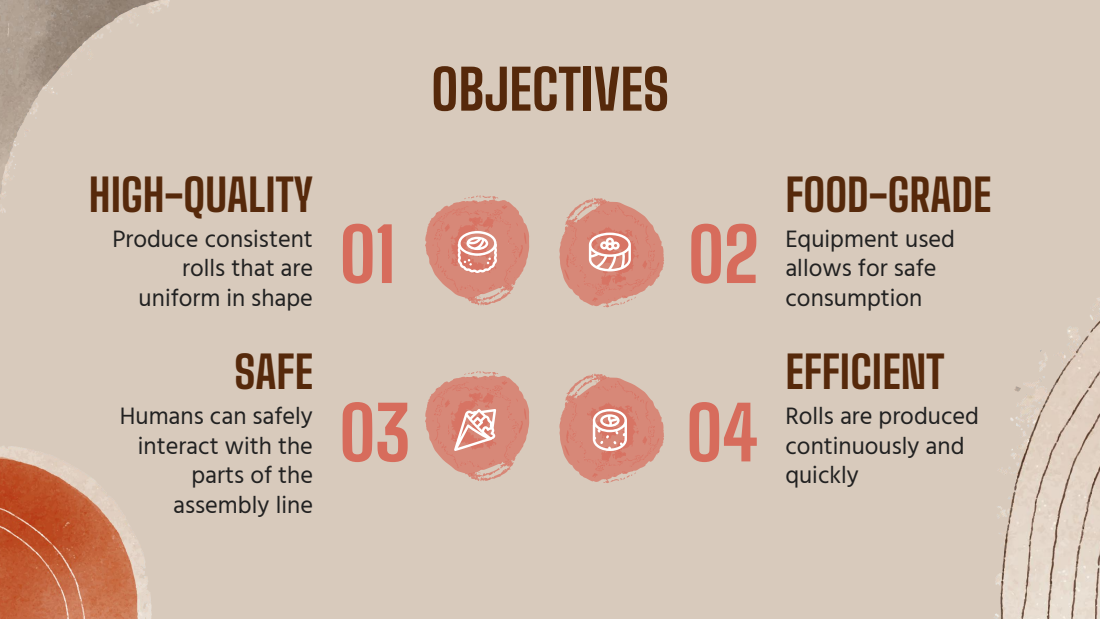
[picture p87: page 6]
HIGH-QUALITY

FOOD-GRADE
Equipment used
allows for safe
consumption
EFFICIENT
Rolls are produced
continuously and
quickly

Produce consistent
rolls that are
uniform in shape
SAFE

Humans can safely
interact with the
parts of the
assembly line

# 5 STATIONS:

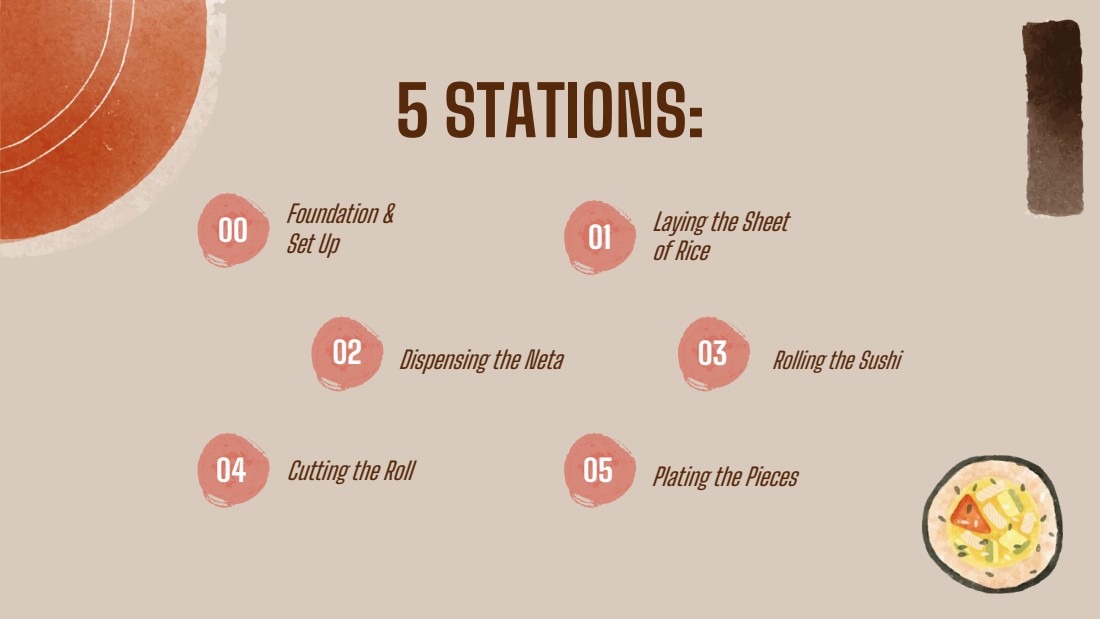
[picture p88: page 7]
00 Foundation & Set Up; 04 Cutting the Roll; 05 Plating the Pieces; 02 Dispensing the Neta; 03 Rolling the Sushi

01 Laying the Sheet
of Rice

# 0. LINEAR MOVING PLATFORM

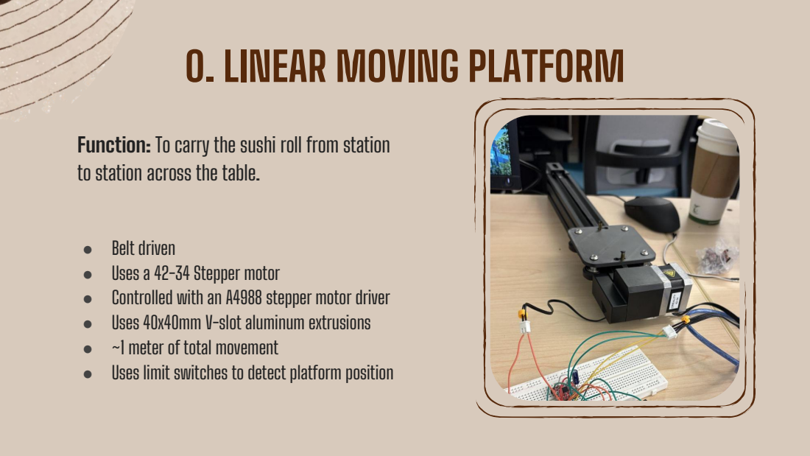
[picture p89: page 8]

Function: To carry the sushi roll from station
to station across the table.

● Belt driven
● Uses a 42-34 Stepper motor
● Controlled with an A4988 stepper motor driver
● Uses 40x40mm V-slot aluminum extrusions
● ~1 meter of total movement
● Uses limit switches to detect platform position

# 1. DISPENSING SHEET OF SUSHI RICE

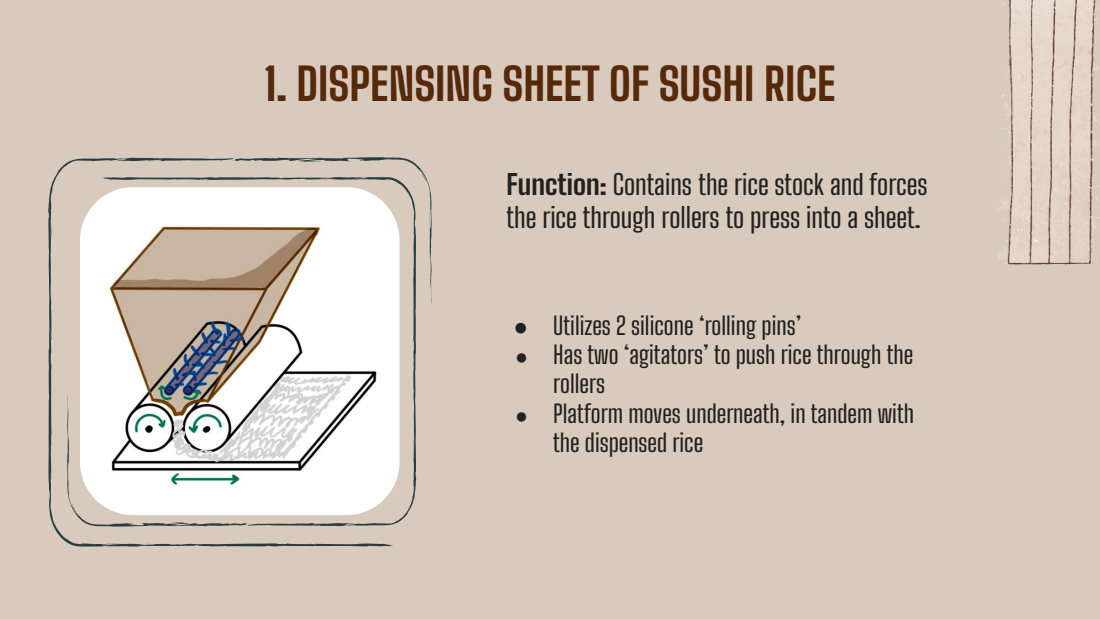
[picture p90: page 9]

Function: Contains the rice stock and forces
the rice through rollers to press into a sheet.

● Utilizes 2 silicone ‘rolling pins’
● Has two ‘agitators’ to push rice through the
rollers
● Platform moves underneath, in tandem with
the dispensed rice

# 2. LAYING OUT INGREDIENTS

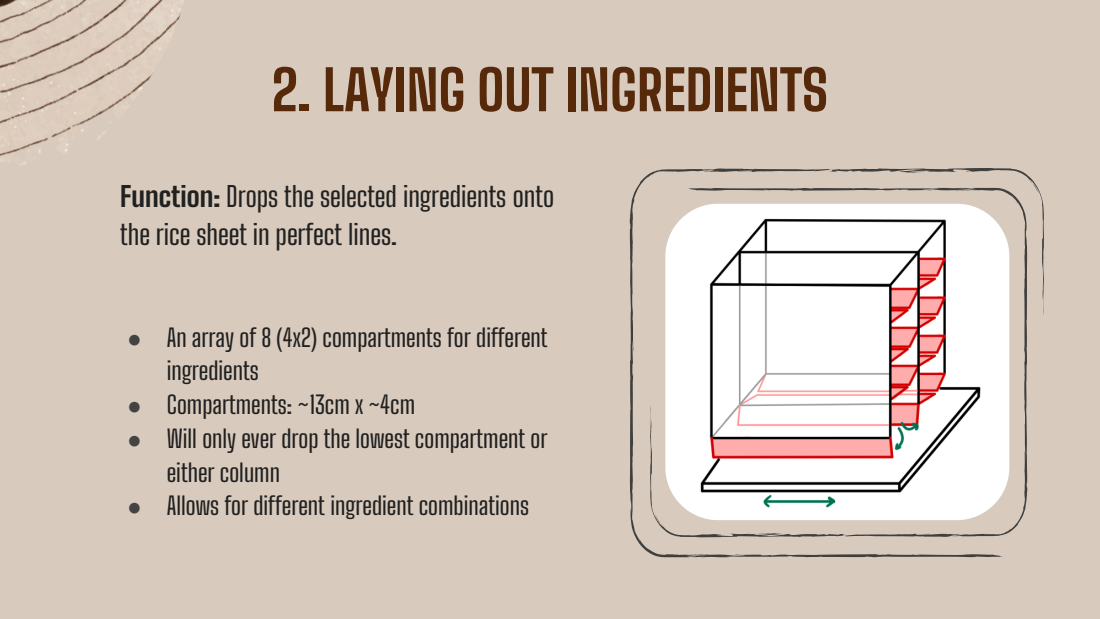
[picture p91: page 10]

Function: Drops the selected ingredients onto
the rice sheet in perfect lines.

● An array of 8 (4x2) compartments for different
ingredients
● Compartments: ~13cm x ~4cm
● Will only ever drop the lowest compartment or
either column
● Allows for different ingredient combinations

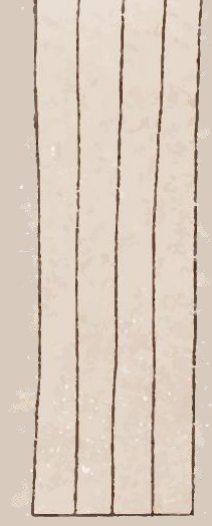
[picture p92: figure]

# 3. ROLLING

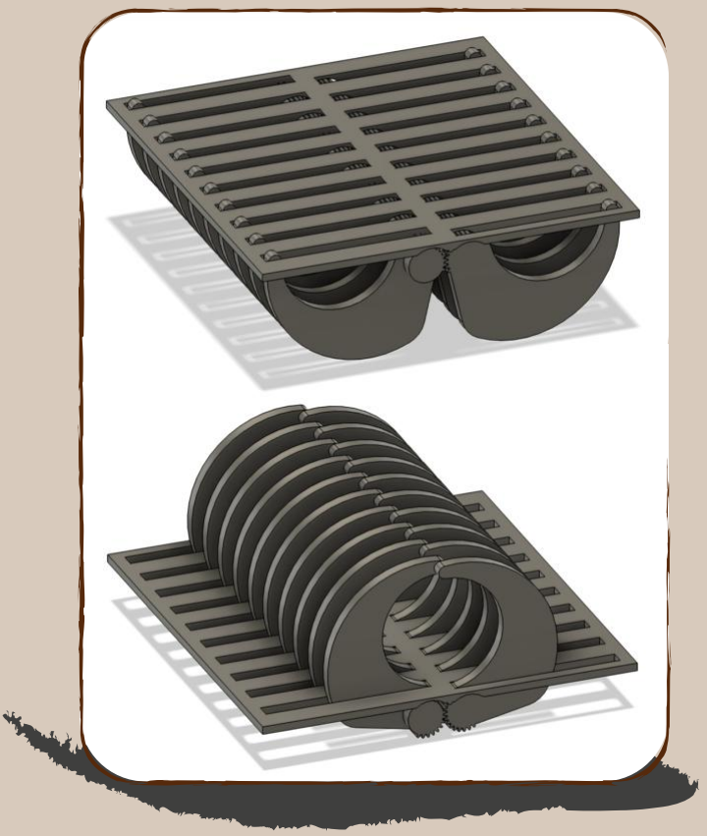
[picture p93: figure]

- Uses a “ribcage” design with prongs that collapse into the roll from the bottom
- A high-torque stepper motor will control one set of ribs, and the other will follow the opposite direction through a gear system
- This platform will be mounted on the linear slide platform and held up by long spacers to give room to the ribs in rest position

Function: Collapses inwards to roll the sushi roll on a bamboo mat.

# 4. CUTTING THE ROLL

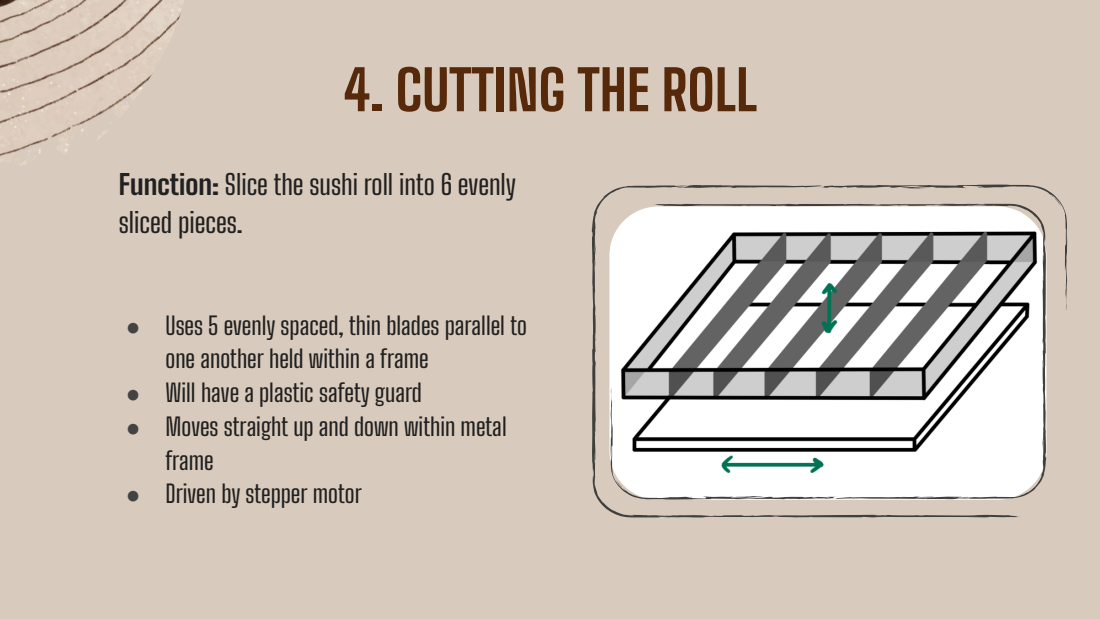
[picture p94: page 12]

Function: Slice the sushi roll into 6 evenly
sliced pieces.

● Uses 5 evenly spaced, thin blades parallel to
one another held within a frame
● Will have a plastic safety guard
● Moves straight up and down within metal
frame
● Driven by stepper motor

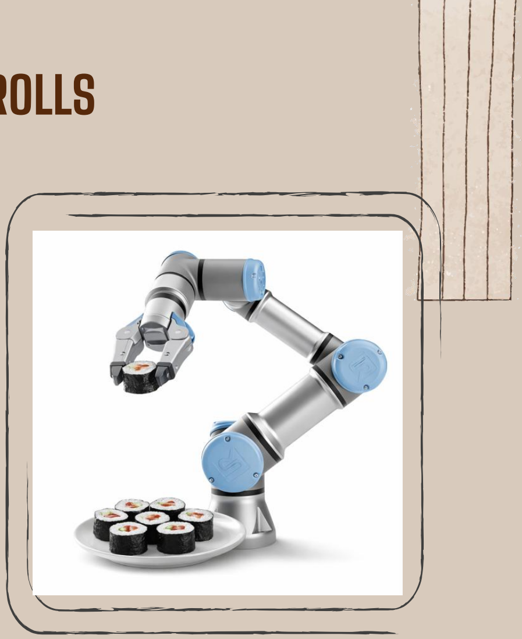
[picture p95: figure]

# 5. PLATING THE ROLLS

- A UR robot with a gripper end-effector will pick and place the finished pieces on the platform one by one
- It will plate them onto a plate in a preprogrammed sequence
- Interfacing the robot controller with the main system controller is on our to-do list
- Learning how to program the robot is on our to-do list

Function: A robot picks and places the finished sushi pieces onto a plate, ready to serve.

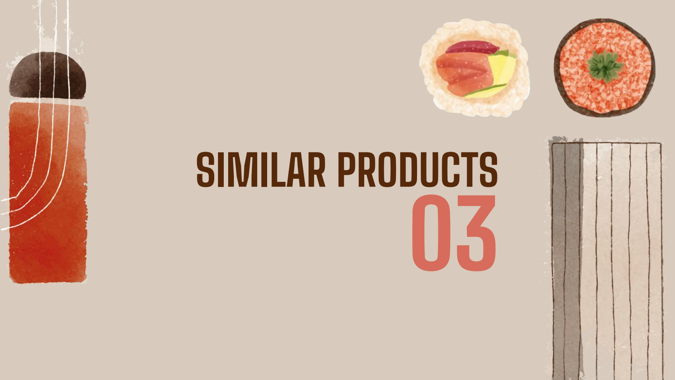
[picture p96: page 14]

# SIMILAR PRODUCTS

03

# AUTEC NORIMAKI

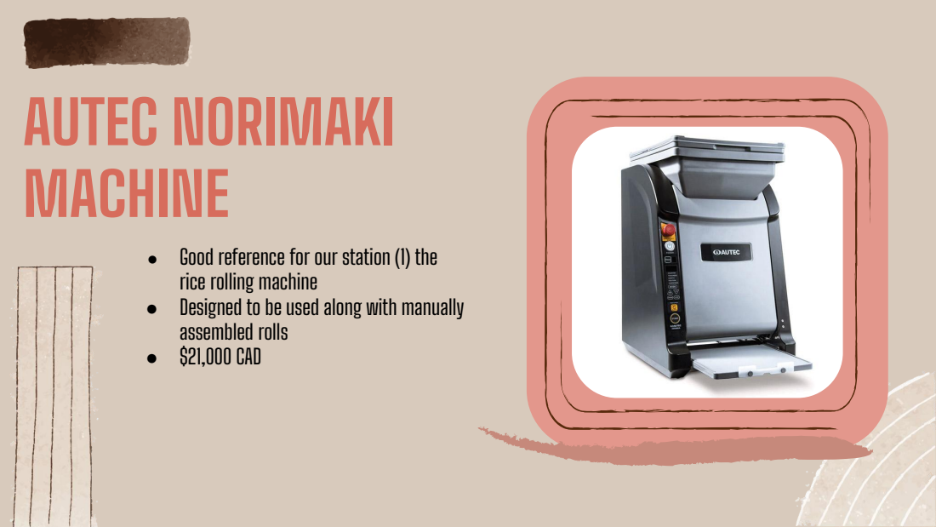
[picture p97: page 15]
MACHINE

● Good reference for our station (1) the
rice rolling machine
● Designed to be used along with manually
assembled rolls
● $21,000 CAD

# SUSHI FACTORY ROLLING MECHANISMS

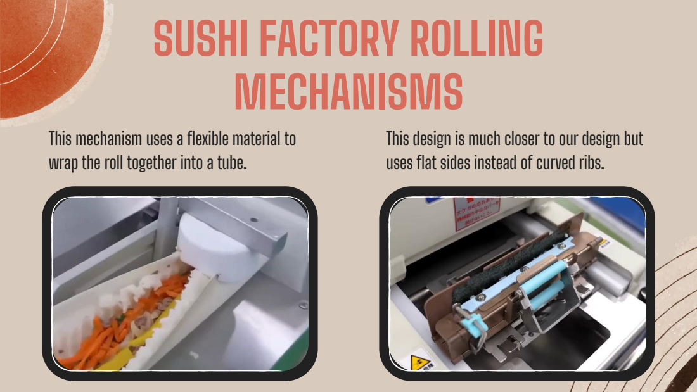
[picture p98: page 16]

This mechanism uses a flexible material to
wrap the roll together into a tube.

This design is much closer to our design but
uses flat sides instead of curved ribs.

04

# WHAT WE’VE ACHIEVED

T
H

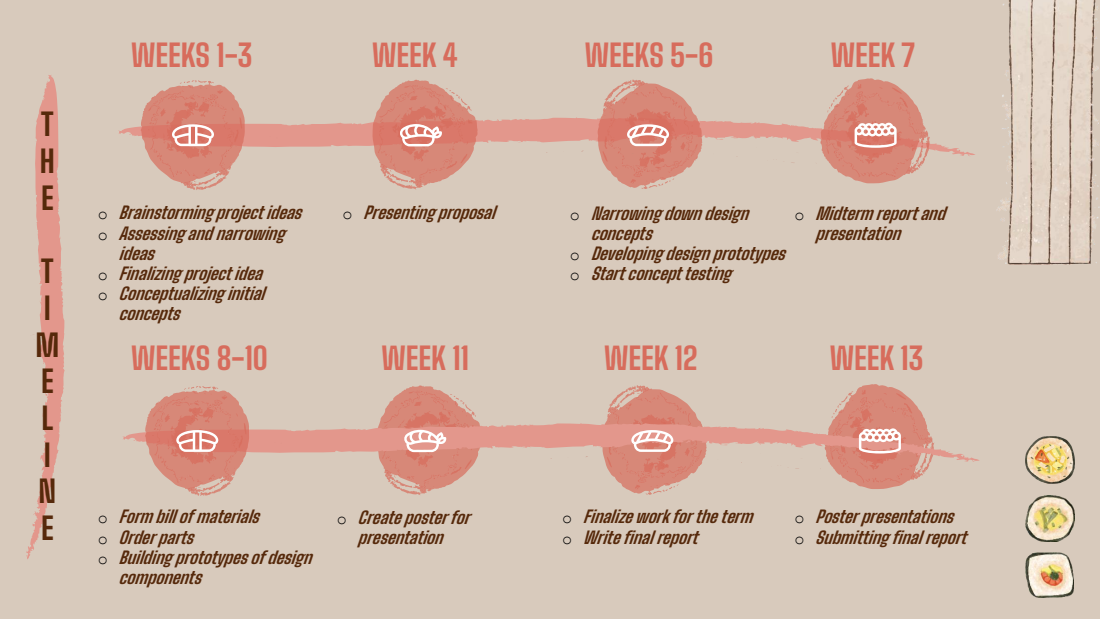
[picture p99: page 18]
• Brainstorming project ideas • Assessing and narrowing ideas • Finalizing project idea • Conceptualizing initial concepts; WEEKS 1-3; WEEK 4; WEEKS 5-6; WEEK 7; • Presenting proposal; o Narrowing down design; • Form bill of materials • Order parts • Building prototypes of design components; WEEKS 8-10; WEEK 11; WEEK 12; WEEK 13

• Midterm report and
presentation

concepts
• Developing design prototypes
• Start concept testing

• Create poster for

• Finalize work for the term
• Write final report

• Poster presentations
• Submitting final report

# PROGRESS ON OPERATION DESIGN

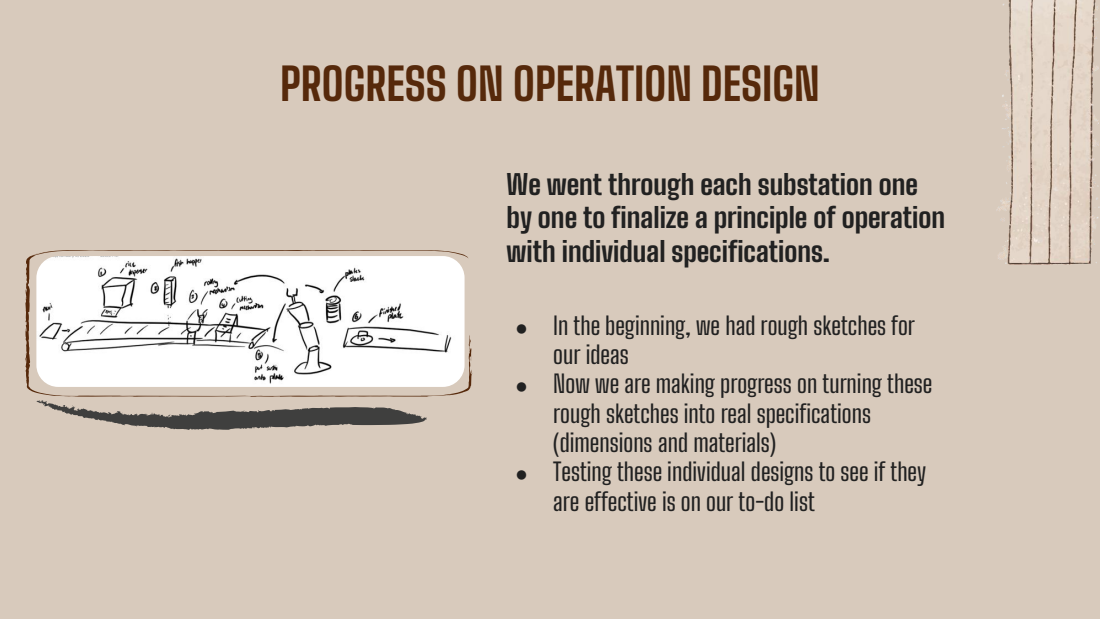
[picture p100: page 19]

We went through each substation one
by one to finalize a principle of operation
with individual specifications.

● In the beginning, we had rough sketches for
our ideas
● Now we are making progress on turning these
rough sketches into real specifications
(dimensions and materials)
● Testing these individual designs to see if they
are effective is on our to-do list

# PROGRESS ON CAD DESIGN

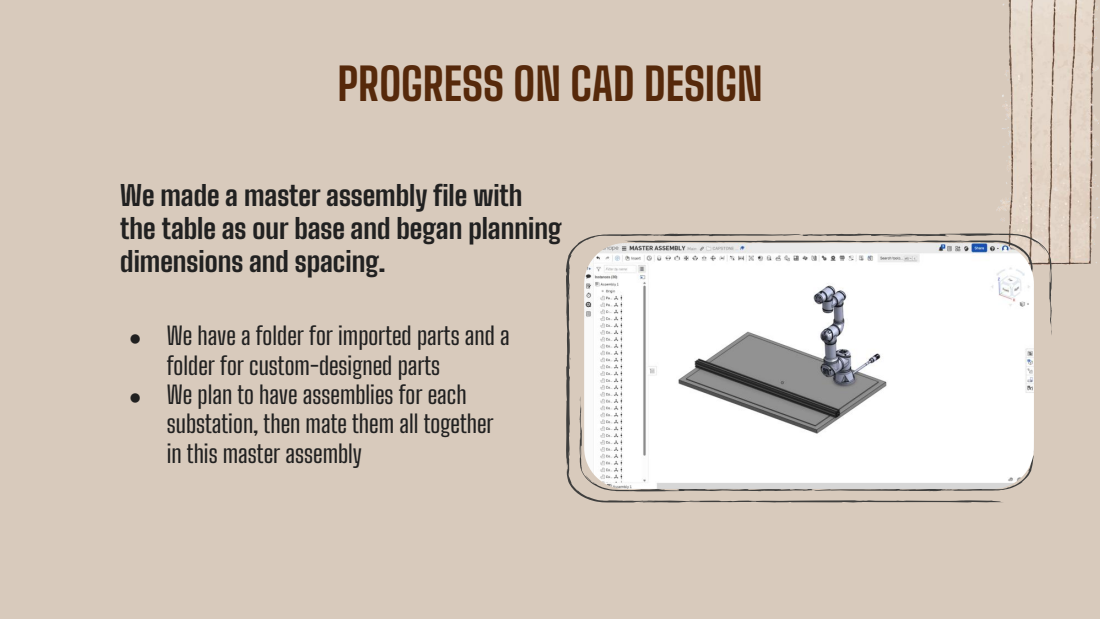
[picture p101: page 20]

We made a master assembly file with
the table as our base and began planning
dimensions and spacing.

● We have a folder for imported parts and a
folder for custom-designed parts
● We plan to have assemblies for each
substation, then mate them all together
in this master assembly

# PROGRESS ON BILL OF MATERIALS

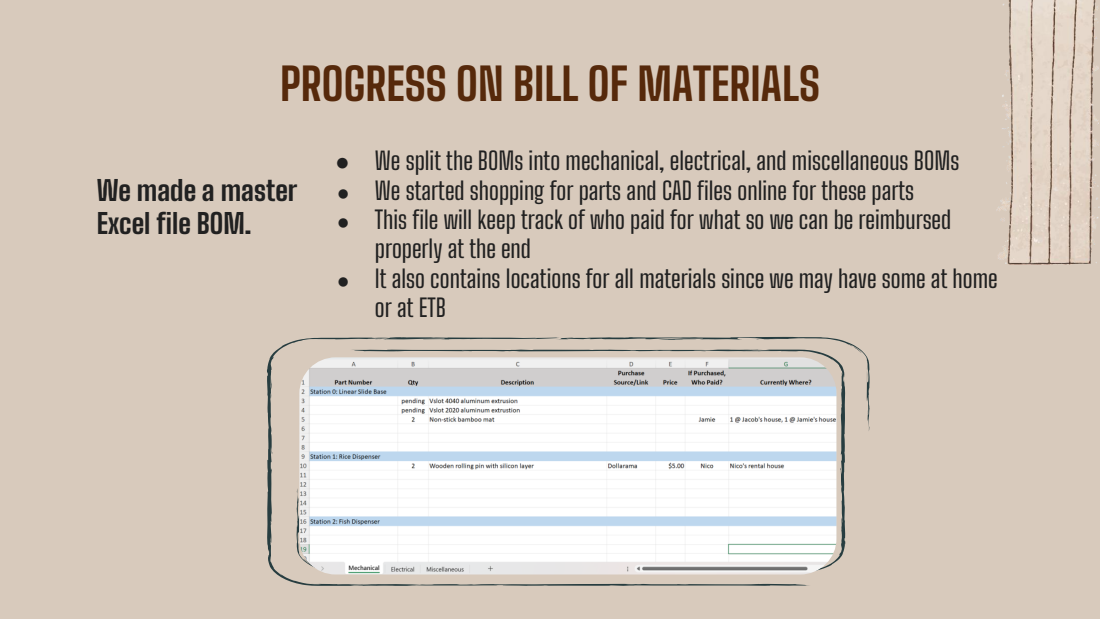
[picture p102: page 21]

● We split the BOMs into mechanical, electrical, and miscellaneous BOMs
● We started shopping for parts and CAD files online for these parts
● This file will keep track of who paid for what so we can be reimbursed
properly at the end
● It also contains locations for all materials since we may have some at home
or at ETB

We made a master
Excel file BOM.

# PROGRESS ON PROTOTYPING & TESTING

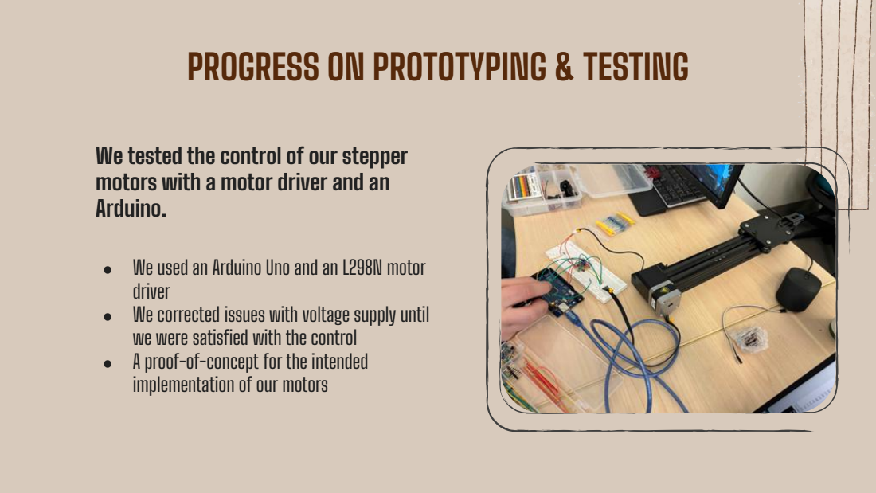
[picture p103: page 22]

We tested the control of our stepper
motors with a motor driver and an
Arduino.

● We used an Arduino Uno and an L298N motor
driver
● We corrected issues with voltage supply until
we were satisfied with the control
● A proof-of-concept for the intended
implementation of our motors

# REFERENCES

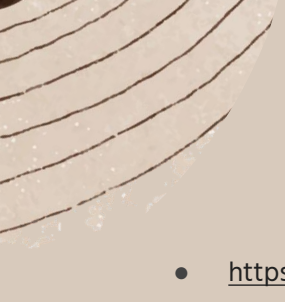
[picture p104: figure]

- https://www.maisonrondeau.com/en/product/autec-asm865a-norimaki-machine-maki-sushi
