NicolasJao/CAPSTONE-4TR1-Sushi-Assembly-Line/Project Documentation/Reports/Semester 1/Sushi Assembly Line Project Plan.pdf

PROCTECH 4TR3 | Sushi Assembly Line Project Plan

# Capstone – Project Plan:

# SUSHI ASSEMBLY LINE

### PROCTECH 4TR3 – C03

September 18th, 2026
Automation Systems Engineering Technology


Prepared For:

Dr. Kostas Apostolou

Prepared By:

Nicolas Jao, 400450151

Jacob Kwan, 400453713

Jamie Williams, 400462359

This report contains our own work for PROCTECH – 4TR3 and has not been submitted, in whole or in part, towards fulfilling requirements in any other course, either at McMaster University or elsewhere. I/We have read McMaster’s academic integrity policy and understand that plagiarism, whether intentional or unintentional, will be dealt with in accordance with university policy and practice.
Name: Nicolas Jao | Date: 09/14/26 | Name: Jamie Williams | Date: 09/14/26
Name: Jacob Kwan | Date: 09/14/26

## Project Statement

Our capstone project proposes a sushi roll production machine designed to significantly reduce the time required to prepare simple maki sushi rolls. Despite being simple in structure, their manual assembly remains slow and laborious. This system automates the core steps of sushi preparation, providing each its own station along an assembly line: layering the nori and rice, adding ingredients, rolling, and slicing.

By streamlining these tasks, this machine supports chefs by freeing them from time-consuming preparation work and enabling greater focus on higher-value culinary tasks. The design will prioritize safety features to emphasize its collaborative nature with existing chefs. It intends to increase productivity and efficiency in large-scale kitchen environments.

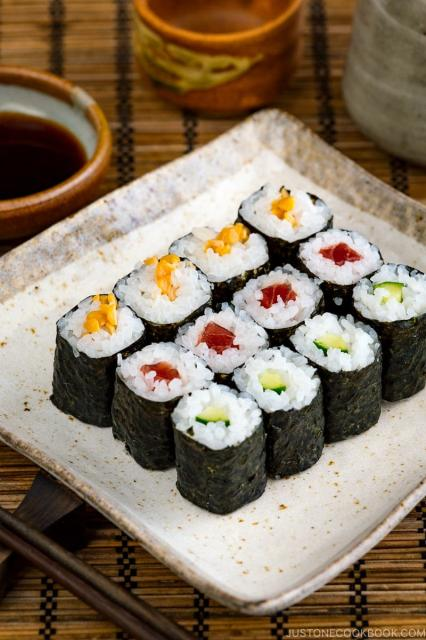
[picture p105: figure]

Figure 1: Image taken from https://www.justonecookbook.com/sushi-rolls/

## Project Timeline

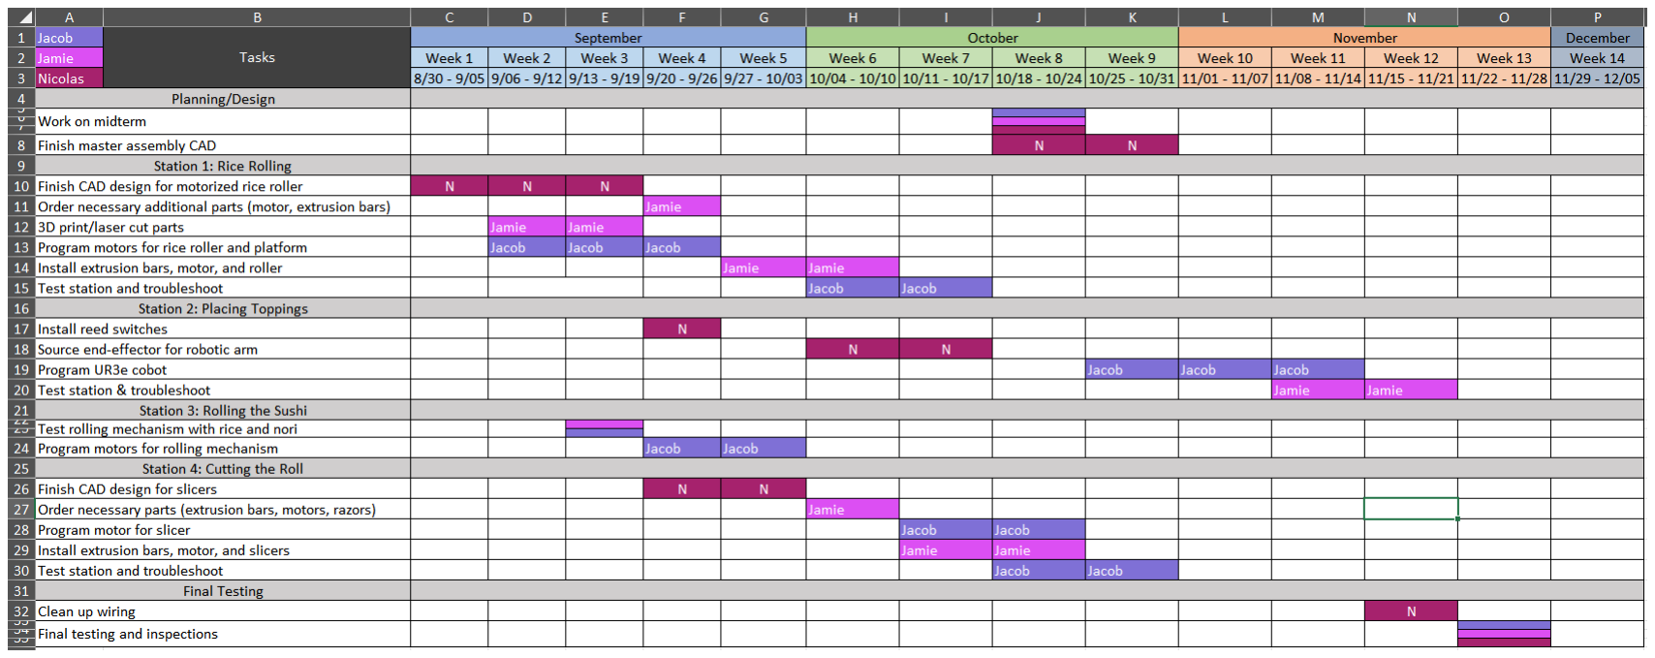
[picture p106: figure]
